DocMuerde/Motor-CC-Control-Lab/datasheets/README.md

# Documentación técnica de componentes / Component technical documentation

[Español](#español) · [English](#english)

## Español

Esta carpeta reúne la documentación técnica y los archivos CAD de los componentes del equipo de prácticas de control de motor CC. Los documentos ya están incluidos en el repositorio y se pueden abrir desde los enlaces siguientes.

### Driver — Toshiba TB6612FNG y placa SparkFun

En [`driver/`](driver/) se incluyen la ficha técnica del circuito integrado y los documentos de diseño de la placa SparkFun:

- [Ficha técnica del TB6612FNG (Toshiba)](driver/TB6612FNG-Datasheet-Toshiba.pdf).
- [Esquema de la placa SparkFun, versión v11c (PDF)](driver/SparkFun_Motor_Driver-TB6612FNG_v11c.pdf).
- [Archivos de diseño Eagle](driver/SparkFun_Motor_Driver-TB6612FNG_v11c/): esquema `.sch` y placa `.brd`.

El diseño de la shield ISA del equipo se encuentra por separado en [`hardware/pcb/`](../hardware/pcb/).

### Encoder — ams AS5047P

En [`encoder/`](encoder/) se incluyen:

- [Ficha técnica del AS5047P (PDF)](encoder/AS5047P-Datasheet.pdf).
- [Imagen del encoder](encoder/AS5047P.png).

### Motor — maxon A-max 22, artículo 110120

En [`motor/`](motor/) se incluyen:

- [Ficha de catálogo del motor (PDF)](motor/Amax22-110120-Datasheet.pdf).
- [Archivos CAD del motor (ZIP)](motor/Amax22-110120-CAD.zip).

### Reductora — maxon GP 22 B, artículo 110356

En [`reductora/`](reductora/) se incluyen:

- [Ficha de catálogo de la reductora (PDF)](reductora/GP22B-110356-Datasheet.pdf).
- [Archivos CAD de la reductora (ZIP)](reductora/GP22B-110356-CAD.zip).

Para utilizar el equipo o instalar su firmware, consulta los [manuales de uso e instalación](../docs/manual/). Esta carpeta contiene material de consulta sobre los componentes.

---

## English

This folder contains technical documentation and CAD files for the components of the DC motor control lab rig. The documents are already included in the repository and can be opened using the links below.

### Driver — Toshiba TB6612FNG and SparkFun board

[`driver/`](driver/) contains the integrated circuit datasheet and the SparkFun board design documents:

- [TB6612FNG datasheet (Toshiba, PDF)](driver/TB6612FNG-Datasheet-Toshiba.pdf).
- [SparkFun board schematic, version v11c (PDF)](driver/SparkFun_Motor_Driver-TB6612FNG_v11c.pdf).
- [Eagle design files](driver/SparkFun_Motor_Driver-TB6612FNG_v11c/): `.sch` schematic and `.brd` board layout.

The rig's ISA shield design is stored separately in [`hardware/pcb/`](../hardware/pcb/).

### Encoder — ams AS5047P

[`encoder/`](encoder/) contains:

- [AS5047P datasheet (PDF)](encoder/AS5047P-Datasheet.pdf).
- [Encoder image](encoder/AS5047P.png).

### Motor — maxon A-max 22, part number 110120

[`motor/`](motor/) contains:

- [Motor catalogue sheet (PDF)](motor/Amax22-110120-Datasheet.pdf).
- [Motor CAD files (ZIP)](motor/Amax22-110120-CAD.zip).

### Gearbox — maxon GP 22 B, part number 110356

[`reductora/`](reductora/) contains:

- [Gearbox catalogue sheet (PDF)](reductora/GP22B-110356-Datasheet.pdf).
- [Gearbox CAD files (ZIP)](reductora/GP22B-110356-CAD.zip).

For instructions on using the rig or installing its firmware, see the [user and installation manuals](../docs/manual/). This folder provides reference material about the components.
