DocMuerde/Motor-CC-Control-Lab/datasheets/motor/README.md

# Motor DC — maxon A-max 22, 5 W (Art. 110120)

## Español

Motor DC de escobillas de la serie A-max de maxon. Utilizado en el equipo de prácticas de control de posición.

### Archivos

| Archivo | Descripción |
|---|---|
| `Amax22-110120-Datasheet.pdf` | Página de catálogo del motor (curvas, parámetros eléctricos y mecánicos) |
| `Amax22-110120-CAD.zip` | Modelo CAD 3D en formato STEP |

### Parámetros principales (Art. 110120)

| Parámetro | Valor |
|---|---|
| Serie | A-max 22 Ø22 mm |
| Potencia nominal | 5 W |
| Tensión nominal | 12 V |
| Escobillas | Metal precioso CLL |
| Terminales | Con terminales (leads) |
| Número de artículo | **110120** |
| Estado | NRND (Not Recommended for New Designs) |

### Referencias

- 🌐 Página del producto: https://www.maxongroup.es/maxon/view/product/110120
- 🌐 Catálogo Maxon: https://www.maxongroup.es

---

<p align="center">🇬🇧 &nbsp;&nbsp; <strong>E N G L I S H</strong> &nbsp;&nbsp; 🇬🇧</p>

---

## English

Brushed DC motor from maxon's A-max 22 series, used in the position-control lab rig.  
Mounted together with the GP 22 B planetary gearbox (Art. 110356) and an inertia disk on the output shaft.

### Files

| File | Description |
|---|---|
| `Amax22-110120-Datasheet.pdf` | Motor catalogue page (curves, electrical and mechanical parameters) |
| `Amax22-110120-CAD.zip` | 3D CAD model in STEP format |

### Main parameters (Art. 110120)

| Parameter | Value |
|---|---|
| Series | A-max 22 Ø22 mm |
| Nominal power | 5 W |
| Nominal voltage | 12 V |
| Brushes | Precious-metal CLL |
| Terminals | With leads |
| Article number | **110120** |
| Status | NRND (Not Recommended for New Designs) |

### References

- 🌐 Product page: https://www.maxongroup.es/maxon/view/product/110120
- 🌐 Maxon catalogue: https://www.maxongroup.es
