DocMuerde/Motor-CC-Control-Lab/datasheets/reductora/README.md

# Reductora — maxon GP 22 B (Art. 110356)

## Español

Reductora planetaria de precisión de la serie GP 22 B de maxon.  
Va acoplada directamente al motor A-max 22 (Art. 110120). El piñón del motor actúa como engranaje de entrada de la primera etapa.

### Archivos

| Archivo | Descripción |
|---|---|
| `GP22B-110356-Datasheet.pdf` | Página de catálogo de la reductora (relación de reducción, par máximo, dimensiones) |
| `GP22B-110356-CAD.zip` | Modelo CAD 3D en formato STEP (cubre también los artículos 110355, 110357–110359) |

### Parámetros principales (Art. 110356)

| Parámetro | Valor |
|---|---|
| Serie | GP 22 B Ø22 mm |
| Par de salida máximo continuo | 0,1 – 0,3 Nm |
| Tipo de cojinete | Sinterizado |
| Montaje | Acoplada de fábrica al motor |
| Número de artículo | **110356** |
| Estado | NRND (Not Recommended for New Designs) |

> ℹ️ Las reductoras GP 22 B solo se venden como parte de una combinación motor + reductora, no de forma independiente.

### Referencias

- 🌐 Página del producto: https://www.maxongroup.es/maxon/view/product/110356
- 🌐 Catálogo Maxon: https://www.maxongroup.es

---

<p align="center">🇬🇧 &nbsp;&nbsp; <strong>E N G L I S H</strong> &nbsp;&nbsp; 🇬🇧</p>

---

## English

Precision planetary gearbox from maxon's GP 22 B series.  
Factory-fitted to the A-max 22 motor (Art. 110120). The motor's pinion serves as the input gear of the first stage.  
Used in the lab rig together with an inertia disk on the output shaft.

### Files

| File | Description |
|---|---|
| `GP22B-110356-Datasheet.pdf` | Gearbox catalogue page (reduction ratio, maximum torque, dimensions) |
| `GP22B-110356-CAD.zip` | 3D CAD model in STEP format (also covers articles 110355, 110357–110359) |

### Main parameters (Art. 110356)

| Parameter | Value |
|---|---|
| Series | GP 22 B Ø22 mm |
| Maximum continuous output torque | 0.1 – 0.3 Nm |
| Bearing type | Sintered |
| Mounting | Factory-fitted to motor |
| Article number | **110356** |
| Status | NRND (Not Recommended for New Designs) |

> ℹ️ GP 22 B gearboxes are only sold as part of a motor + gearbox combination, not separately.

### References

- 🌐 Product page: https://www.maxongroup.es/maxon/view/product/110356
- 🌐 Maxon catalogue: https://www.maxongroup.es
