DocMuerde/Motor-CC-Control-Lab/Claude outputs/lab01_isa.pdf

Control Automático ITT | Práctica 1 Equipo GEPOC

### Control Automático

2

### o Curso Grado en Ingeniería de las Tecnologías de la Telecomunicación

## Práctica de Laboratorio 1

Análisis de un motor de corriente continua

Dpto. de Ingeniería de Sistemas y Automática GEPOC
Universidad de Sevilla | | | ialvarado@us.es

## 1 Objetivos

En esta práctica se va a familiarizar con el equipo de laboratorio basado en Arduino diseñado por el grupo GEPOC, que permite controlar un motor de corriente continua con lazo de control íntegramente en MATLAB/Simulink. Los objetivos concretos son:

Familiarizarse con el hardware y el modelo de Simulink del equipo.
Leer la posición angular y la velocidad proporcionadas por el encoder magnético. Estudiar la calidad de la medida de velocidad y el efecto del ltrado.
Identicar la función de transferencia del motor (ganancia estática K y constante de tiempo τ ) mediante ensayos de escalón.

## 2 Descripción del equipo GEPOC

El banco de prácticas está formado por los siguientes elementos (gura 1):

Motor CC: Maxon A-max 22, con reductora planetaria GP 22B. Encoder: AS5047P, encoder magnético absoluto de 14 bits (2

14 = 16 384 pasos/vuelta), sin contacto y sin rozamiento.
Driver: TB6612FNG, puente en H doble; permite PWM bipolar u ∈ [−255, 255]. Arduino UNO: actúa como nodo de adquisición y actuación. Lee el encoder por SPI, calcula la velocidad y se comunica con el PC mediante protocolo serie binario a 115 200 baud, con período de muestreo Ts = 10 ms (100 Hz).
PC con MATLAB/Simulink: ejecuta el algoritmo de control e intercambia datos con el Arduino a través del puerto USB/serie.

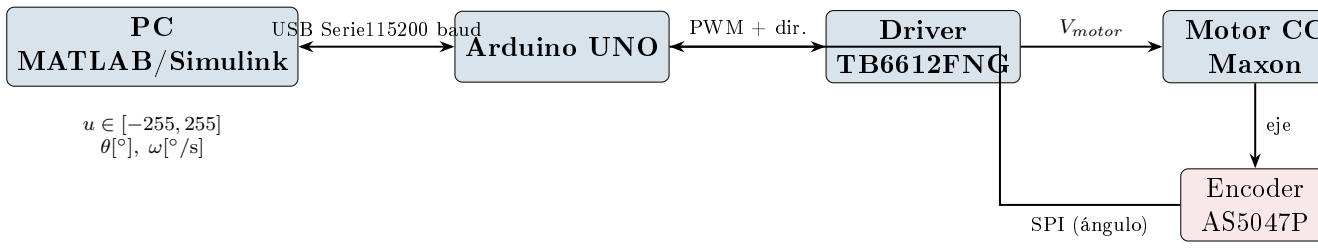
[picture p12: figure]
MATLAB/Simulink; Arduino UNO; Driver; TB6612FNG; Motor CC Maxon; Encoder AS5047P; USB Serie115200 baud; PWM + dir.; Vmotor; eje; SPI (ángulo)

Figure 1: Esquema del equipo de prácticas GEPOC.

### 2.1 Protocolo de comunicación serie

El Arduino y MATLAB intercambian paquetes binarios cada Ts = 10 ms:

Dirección | Trama (bytes) | Contenido
Arduino → MATLAB 'V' | oat θ | oat ω | oat u | '\n' θ [°], ω [°/s], eco de u
MATLAB → Arduino 'A' | int16 u | '\n' | señal de control u ∈ [−255, 255]

La señal de control equivalente en tensión es:

| Veq = u · Vcc
| 255

≈ u ·

12
255
[V] | (1)

## 3 El modelo de Simulink MotorCC_V2

Toda la comunicación serie está encapsulada en el bloque Motor_CC dentro del modelo MotorCC_V2.slx. Los estudiantes no necesitan congurar bloques serie manualmente.

### 3.1 Apertura y conguración del puerto

1. Conecte el cable USB entre el Arduino y el PC.
2. Abra MATLAB y navegue hasta la carpeta del proyecto (software/matlab/).
3. Abra el modelo: open('MotorCC_V2.slx').
4. Haga doble clic sobre el bloque Motor_CC. El diálogo escaneará automáticamente los puertos serie disponibles y los mostrará en el desplegable Puerto serie. Seleccione el puerto del Arduino (p. ej., COM3 en Windows o /dev/tty.usbmodem... en macOS/Linux) y pulse OK.

### 3.2 Entradas y salidas del bloque Motor_CC

El modelo base ya incluye una entrada Constant (valor 50) y un bloque Scope conectados al bloque Motor_CC. Puede modicar el valor de la constante y conectar bloques adicionales según necesite en cada apartado.

Nota

El motor gira en ambas direcciones según el signo de u. Comience con valores pequeños (|u| ≤ 50) para evitar golpes bruscos. La simulación se ejecuta en tiempo real sincronizada con el Arduino.

## 4 Señal de actuación y lectura del sensor

En este apartado va a comprobar el funcionamiento básico del equipo: aplicar una señal de control constante y observar la respuesta del motor.

1. Congure el bloque Constant con el valor u = 50.

2. Ajuste el tiempo de parada de la simulación a 5 s en la barra de herramientas de Simulink.
3. Pulse Run. El scope debe mostrar el ángulo y la velocidad del motor.
4. Repita con u = −50 y con u = 0.

Pregunta #1 Resolución del encoder

a) ¾Cuántos pasos da el encoder AS5047P por revolución?
b) Calcule la resolución en grados y en radianes por paso.
c) El Arduino envía el ángulo acumulado en grados. Si se desea trabajar en radianes, ¾qué factor de conversión hay que aplicar en Simulink?

Pregunta #2 Señal de actuación y velocidad en régimen permanente

Con u = 50:

a) ¾Cuál es la velocidad en régimen permanente en °/s?
b) Convierta ese valor a rad/s.
c) ¾Qué tensión equivalente Veq [V] corresponde a u = 50?
d) ¾Qué ocurre si invierte el signo de u? ¾Y si pone u = 0?

## 5 Medida de velocidad

El Arduino calcula la velocidad como la variación de ángulo entre dos períodos consecutivos:

ω[k] = θ[k] − θ[k − 1]
Ts

[

◦
/s] | (2)

con Ts = 10 ms. Esta diferencia discreta amplica el ruido de cuanticación del encoder.

### 5.1 Observación del ruido de velocidad

1. Aplique u = 50 y observe en el Scope la señal de velocidad ω en régimen permanente. Haga zoom en unos pocos ciclos para apreciar la variación de muestra a muestra.
2. Estime visualmente la amplitud pico a pico del ruido de velocidad.

### 5.2 Filtrado paso bajo de la velocidad

Para atenuar el ruido, se puede añadir un ltro paso bajo de primer orden en Simulink:

F(s) = ωc
s + ωc

(3)

Añada un bloque Transfer Fcn entre la salida ω del bloque Motor_CC y el Scope, con numerador [ωc] y denominador [1, ωc]. Pruebe con ωc = 50 rad/s (frecuencia de corte ≈ 8 Hz).

Nota

Recuerde establecer el tiempo de muestreo del bloque Transfer Fcn en −1 (hereda del solver). El solver de Simulink debe ser de paso jo con Tstep = 0.01 s.

Pregunta #3 Calidad de la medida de velocidad

a) ¾Cuál es la resolución mínima de velocidad que puede detectar el encoder para Ts = 10 ms? (Recuerde: 16 384 pasos/vuelta.)
b) Compare cualitativamente la señal de velocidad sin ltrar y con el ltro F(s) = 50/(s + 50): ¾qué mejora se observa en el ruido? ¾Y qué retardo introduce el ltro?
c) ¾Qué criterio usaría para elegir ωc? Razone en términos de compromiso entre atenuación de ruido y retardo.

## 6 Identicación de la función de transferencia

Se va a identicar el modelo de primer orden del motor usando ensayos de escalón:

G(s) = Ω(s)
Veq(s)

=

K
τs + 1

(4)

donde Ω(s) es la velocidad en rad/s, Veq(s) es la tensión equivalente en voltios, K [rad s⁻¹ V⁻¹ ]
es la ganancia estática y τ [s] la constante de tiempo.

### 6.1 Procedimiento

1. Modique el modelo para que el bloque Constant proporcione la señal de control.
| Para el ensayo de escalón, utilice u = 50 (equivalente a Veq ≈ 2.35 V).
2. Añada una conversión a rad/s multiplicando la salida ω por π/180 (bloque Gain).
3. Congure la simulación para al menos 2 s de duración.
4. Ejecute la simulación partiendo del motor en reposo.
5. Exporte los datos del Scope a MATLAB pulsando el botón Log/unlog signals o
| usando simout con un bloque To Workspace.
6.2 | Determinación gráca de K y τ

A partir de la respuesta al escalón (gura 2):

Ganancia estática:
K =

ωss

Veq

(5)

donde ωss es la velocidad en régimen permanente.
Constante de tiempo: τ es el tiempo que tarda la velocidad en alcanzar el 63.2% de ωss desde el inicio del escalón.

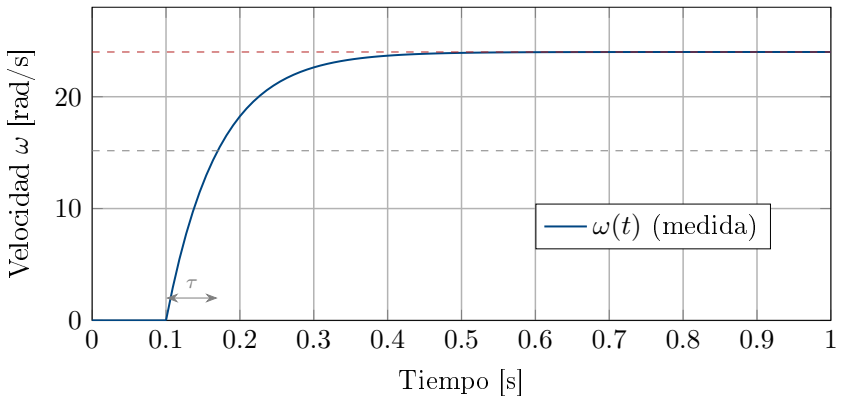
[picture p13: figure]
Tiempo [s]; Velocidad; ω [rad/s]; ω(t) (medida)

Figure 2: Respuesta al escalón de velocidad. Se identican grácamente la velocidad en régimen permanente ωss y la constante de tiempo τ .

Pregunta #4 Función de transferencia (con y sin reductora)

a) Aplique el escalón u = 50 (Veq ≈ 2.35 V) y determine ωss en rad/s.
b) Calcule la ganancia estática K usando la ecuación (5).
c) Determine τ grácamente a partir de la curva de respuesta.
d) Escriba la función de transferencia G(s) = K/(τs + 1) con los valores obtenidos.

Pregunta #5 Validación del modelo

a) Repita el ensayo con u = −50. ¾Es el sistema simétrico? ¾Obtiene los mismos valores de K y τ?
b) Repita con u = 100. ¾Se mantiene la linealidad? Razone la respuesta.
c) Usando la función de transferencia identicada y la herramienta step de MATLAB (o el bloque Transfer Fcn en Simulink), superponga la respuesta del modelo sobre la medida experimental. ¾El ajuste es satisfactorio?

Pregunta #6 Efecto de la reductora

El motor lleva acoplada una reductora planetaria GP 22B. ¾Cómo afecta la reductora a la constante de tiempo τ y a la ganancia estática K en comparación con un motor sin reductora? Razone cualitativamente.

## Hoja de respuestas

### Hoja de respuestas Práctica 1

Nombre:

Dato solicitado | Respuesta
#1 Resolución del encoder

#2 Velocidad en régimen permanente (u = 50)

#3 Calidad de la medida de velocidad

#4 Función de transferencia G(s)

#5 Validación del modelo

#6 Efecto de la reductora

## A El encoder magnético AS5047P

A diferencia de los encoders ópticos incrementales, el AS5047P es un encoder magnético absoluto de 14 bits. Sus principales características son:

Resolución: 2

14 = 16 384 posiciones por vuelta ⇒ resolución de 360/16 384 ≈ 0.022 /paso.
Lectura absoluta: No necesita referencia inicial (homing) ni contador de pulsos; devuelve el ángulo directamente en cada lectura SPI.
Sin contacto: El sensor lee el campo magnético de un imán solidario al eje; no hay desgaste mecánico ni rozamiento.
Interfaz: SPI a hasta 10 MHz (el rmware usa 400 kHz para mayor robustez).

El rmware de Arduino acumula el ángulo entre vueltas para proporcionar una posición angular absoluta ilimitada:

θabs[k] = θraw[k] + 360 · nvueltas | (6)

donde θraw ∈ [−180, 180) y nvueltas se actualiza cada vez que se detecta un cruce por ±180. La velocidad se calcula directamente en el rmware como:

ω[k] = θabs[k] − θabs[k − 1] Ts

[

◦
/s], | Ts = 10 ms | (7)
