DocMuerde/Motor-CC-Control-Lab/Claude outputs/lab02_isa.pdf

Control Automático ITT | Práctica 2 Equipo GEPOC

### Control Automático

2

### o Curso Grado en Ingeniería de las Tecnologías de la Telecomunicación

## Práctica de Laboratorio 2

Control PID de un motor de corriente continua

Dpto. de Ingeniería de Sistemas y Automática GEPOC
Universidad de Sevilla | | | ialvarado@us.es
1 | Objetivos

Esta práctica continúa el trabajo iniciado en la práctica 1 con el equipo GEPOC. Los objetivos son:

Repetir la identicación del sistema y analizar la zona muerta del motor.
Diseñar e implementar un controlador de velocidad: primero proporcional (P) y después proporcional-integral (PI).
Diseñar e implementar un controlador de posición: proporcional-derivativo (PD) y proporcional-integral-derivativo (PID).
Comprender la inuencia de cada parámetro del controlador PID y el efecto de la zona muerta en el error en régimen permanente.

Nota

Para toda esta práctica puede suponer que el punto de funcionamiento en tensión es nulo (V0 = 0), por lo que no es necesario el paso a variables incrementales.

2 | Análisis del sistema
2.1 | Identicación (revisión)
1. Abra el modelo MotorCC_V2.slx y congure el puerto serie haciendo doble clic en el bloque Motor_CC.
2. Partiendo del modelo de Simulink de la práctica 1 (bloque Motor_CC con la salida de velocidad en rad/s, opcionalmente ltrada), aplique un escalón desde u = 0 hasta u = 42 (Veq ≈ 2.0 V) y verique que el modelo funciona correctamente.

Pregunta #1 Función de transferencia

Repita la identicación del apartado 3 de la práctica 1 con el escalón u = 42 (Veq ≈ 2.0 V). Anote la función de transferencia G(s) = K/(τs + 1) con los valores de K y τ obtenidos. Esta función de transferencia se utilizará en los apartados siguientes.

### 2.2 Zona muerta

La zona muerta es un fenómeno no lineal: por debajo de cierta tensión de entrada, el motor no se mueve porque la fricción estática del conjunto motor+reductora supera el par motor. Los límites de zona muerta son distintos para cada sentido de giro.

1. Congure el bloque Constant con un valor inicial u = 5. Ejecute la simulación y compruebe si el motor se mueve observando la señal de velocidad ω en el Scope.
2. Vaya aumentando u de en 1 en 1 hasta detectar el valor mínimo para el cual el motor gira. Anótelo como u

+
ZM.
3. Repita con valores negativos para encontrar u

−
ZM.

Pregunta #2 Zona muerta

a) ¾Cuáles son los límites de la zona muerta u

+
ZM y u

−
ZM?
b) Conviértalos a tensión equivalente: V

±
ZM = u

±
ZM · 12/255.
c) ¾Es la zona muerta simétrica para ambos sentidos? ¾Por qué podría no serlo?
d) ¾Qué implicación tiene la zona muerta para los controladores que diseñará a continuación?

## 3 Control de la velocidad del motor

La gura 1 muestra el esquema de control de velocidad en bucle cerrado. La referencia ωr se compara con la velocidad medida ω; el error e = ωr −ω es procesado por el controlador C(s) para generar la señal de control u.

+ | C(s) | G(s) = | K τs + 1
ωr
e | u | ω

−−

Figure 1: Esquema de control de velocidad en bucle cerrado.

### 3.1 Controlador proporcional (P)

1. Modique el modelo de Simulink para implementar un controlador P: añada un
| bloque Sum que reste la velocidad medida a la referencia, conecte la salida al bloque Motor_CC a través de un Gain Kp.
2. Como referencia, use un Pulse Generator con amplitud ±20 rad/s y frecuencia
| 0.4 Hz (período 2.5 s).
3. Pruebe distintos valores de Kp y analice el comportamiento del sistema (error en
| régimen permanente, sobreimpulso, oscilaciones).

4. Introduzca perturbaciones presionando suavemente el eje del motor con un dedo y observe la reacción del controlador.

Pregunta #3 Controlador proporcional

a) ¾Existe error en régimen permanente con el controlador P? ¾A qué se debe? (Pista: recuerde el tipo del sistema en bucle cerrado.)
b) ¾Cómo afecta aumentar Kp al error y a la estabilidad?
c) ¾Responde el sistema adecuadamente a las perturbaciones? ¾Qué valor de Kp parece un compromiso razonable?

### 3.2 Diseño analítico del controlador PI

El objetivo de diseño es conseguir que el sistema en bucle cerrado se comporte como un sistema de primer orden con constante de tiempo τcl = 0.1 s y ganancia estática unitaria. El controlador PI tiene la forma:

C(s) = Kp

Tis + 1
Tis

(1)

La función de transferencia en bucle cerrado con el controlador (1) y la planta G(s) = K/(τs + 1) es:
T(s) = C(s) G(s)
1 + C(s) G(s)

(2)

Procedimiento de diseño (cancelación polo-cero):

1. Cancelación: Elija Ti = τ para cancelar el polo de la planta. Así C(s) G(s) = KpK/(Tis).
2. Especicación: La función de bucle cerrado resultante es:

T(s) = 1

Ti
KpK

s + 1

=

1
τcl s + 1

⇒ τcl =

Ti
KpK

(3)

3. Cálculo: De (3) se obtiene Kp = Ti/(K τcl) = τ/(K · 0.1 s).
1. Calcule Kp y Ti con la función de transferencia identicada en #1.
2. Implemente el controlador PI en Simulink usando un bloque Transfer Fcn con numerador [KpTi

, Kp] y denominador [Ti

, 0], o bien con un bloque PID Controller con Kp, Ki = Kp/Ti
, Kd = 0.
3. Añada una saturación a la salida del controlador para limitar u ∈ [−255, 255].
4. Ejecute la simulación con la referencia en escalones ±20 rad/s a 0.4 Hz.

Pregunta #4 Control PI de velocidad

a) Anote los valores de Kp y Ti calculados.
b) ¾Se elimina el error en régimen permanente? ¾Por qué el PI consigue esto?
c) Si es necesario, ajuste Kp manualmente para mejorar la respuesta (rapidez, sobreimpulso). Anote el valor nal utilizado.
d) Introduzca perturbaciones con el dedo. ¾Cómo responde el PI frente al controlador P? Razone en base a la acción integral.

## 4 Control de la posición del motor

Ahora la variable a controlar es la posición angular θ en radianes. El esquema de control es idéntico al de la gura 1 pero con θr como referencia y θ como salida (gura 2).

+ | C(s) | Gθ(s) = | K τs² + s
θr
e | u | θ

−−

Figure 2: Esquema de control de posición en bucle cerrado. La planta Gθ(s) incluye el integrador implícito entre velocidad y posición.

La función de transferencia de la posición respecto a la tensión es:

Gθ(s) = Θ(s)
Veq(s)

=

G(s)
s

=

K
s(τs + 1) | (4)

pues la posición es la integral de la velocidad.

### 4.1 Diseño analítico del controlador PD

El objetivo de diseño para posición es un sistema en bucle cerrado de primer orden con τcl = 0.02 s y ganancia estática unitaria.
El controlador PD (con la derivada ltrada para que sea implementable):
C(s) = Kp (1 + Td s) | (5)

Procedimiento (cancelación polo-cero):

1. Elija Td = τ para cancelar el polo de la planta. La función de bucle resulta C(s) Gθ(s) = KpK/s.
2. La función de bucle cerrado es:

T(s) = KpK/s
1 + KpK/s =

1

1
KpK

s + 1

=

1
τcl s + 1

⇒ Kp =

1
K τcl

(6)

3. Calcule Kp con τcl = 0.02 s.

Nota

La acción derivativa pura es no implementable. Use el bloque PID Controller de Simulink con Kd y un ltro de derivada con coeciente N (el PD queda: C(s) = Kp + KpTds N/(s + N)). Comience con N = 100.

1. Modique el modelo de Simulink para controlar la posición:

Conecte la salida de posición θ [°] del bloque Motor_CC, conviértala a rad (multiplicar por π/180) y réaliméntela.
Como referencia, use un Pulse Generator con amplitud ±0.5 rad y frecuencia 0.1 Hz (período 10 s).
2. Implemente el controlador PD con Kp calculado y Td = τ .
3. Ejecute la simulación y analice el resultado.

Pregunta #5 Control PD de posición

a) Anote los valores de Kp y Td calculados.
b) ¾Se obtiene el comportamiento de primer orden esperado con τcl = 0.02 s?
c) ¾Existe error en régimen permanente? ¾A qué se debe? (Pista: piense en el efecto de la zona muerta.)
d) Si es necesario, ajuste Kp manualmente para mejorar la respuesta. ¾Qué compromiso aparece al aumentar Kp?

### 4.2 Control PID: reducción del error en régimen permanente

El error en régimen permanente con control PD se debe principalmente a la zona muerta:
el controlador no puede generar la pequeña acción de control necesaria para compensar la fricción estática. La acción integral del PID puede reducir (aunque no eliminar completamente) este error.
1. Parta del controlador PD anterior y añada acción integral:
| C(s) = Kp
| 1 +
| 1 Tis + Tds
(7)
| Comience con un valor de Ti grande (p. ej., Ti = 1 s) y vaya reduciéndolo mientras el sistema permanezca estable.
2. Observe el efecto de la acción integral sobre el error en régimen permanente y sobre
| el sobreimpulso.
3. Ajuste los tres parámetros Kp, Ti y Td por prueba y error para obtener la mejor
| respuesta posible (mínimo error y mínimo sobreimpulso).

Pregunta #6 Control PID de posición

a) Anote los parámetros nales del PID (Kp, Ti

, Td).

b) ¾Se reduce el error en régimen permanente con la acción integral? ¾Lo elimina completamente? ¾Por qué?
c) ¾Qué problema aparece si Ti es demasiado pequeño?
d) Razone si es posible diseñar un PID analíticamente cuando el sistema presenta zona muerta. ¾Qué herramientas de diseño serían necesarias?
e) Compare las respuestas PD y PID en la misma gráca. ¾Cuál preferiría para esta aplicación? Justique la respuesta.

## Hoja de respuestas

### Hoja de respuestas Práctica 2

Nombre:
Dato solicitado | Respuesta
#1 Función de transferencia G(s)

#2 Límites de zona muerta (u + ZM, u − ZM)

#3 Comportamiento controlador P (Kp elegido)

#4 Control PI de velocidad (Kp, Ti)

#5 Control PD de posición (Kp, Td)

#6 Control PID de posición (Kp, Ti , Td)

## A Implementación del controlador PID en Simulink

Simulink dispone del bloque PID Controller (en la librería Simulink/Continuous) que implementa directamente el PID en la forma:

| u(t) = Kp e(t) + Kp Ti

Z t
| 0 e(σ) dσ + Kp Td N e(t) 1 + N R t
| 0 e(σ) dσ · . . .

(8)

o de forma equivalente en frecuencia:

| C(s) = Kp + Kp Ti s + Kp Td N s s + N
(9)

donde N es el coeciente de ltrado de la derivada. Un valor típico de N ∈ [20, 200] asegura que la derivada sea implementable y no amplique excesivamente el ruido de alta frecuencia.
Congure el bloque PID en MATLAB/Simulink de la siguiente manera:
1. Arrastre un bloque PID Controller al diagrama.
2. Haga doble clic y seleccione el tipo (P, PI, PD o PID).
3. Introduzca los parámetros Kp (proporcional), Ti (integral), Td (derivativo) y N (ltro de derivada).
4. Añada siempre un bloque Saturation a la salida del controlador limitando u ∈ [−255, 255] para no saturar el driver del motor.

### Anti-windup

Cuando la señal de control satura, el integrador puede seguir acumulando error (windup), provocando sobretensiones al salir de la saturación. Habilite el anti-windup en el bloque PID seleccionando el método Back-calculation con constante de rastreo Kb = 1/Ti
