DocMuerde/Motor-CC-Control-Lab/labs/lab01/figuras/README.txt

Figuras pendientes para lab01_slides.tex
=========================================

Sección 2 — Lab virtual con Simulink
--------------------------------------
[ ] simulink_modelo_completo.png   — Vista del modelo MotorCC_V3.slx completo
[ ] simulink_dashboard_knob.png    — Knob + Edit configurados para u
[ ] simulink_dashboard_scope.png   — Dashboard Scope con dos señales (u, omega)
[ ] simulink_pacing.png            — Configuración Simulation Pacing (1x real-time)
[ ] simulink_data_inspector.png    — Data Inspector con señales logged

Sección 3 — Puesta en marcha
------------------------------
[ ] verificacion_u50.png           — Scope con u=50 y omega estabilizada
[ ] verificacion_u-50.png          — Scope con u=-50 (giro inverso)

Sección 4 — Experimentos
--------------------------
[ ] exp1_saturacion.png            — Scope exp. saturación (u=300 vs u=255)
[ ] exp2_estatica_grafica.png      — plot(u_vec, w_vec) característica estática
[ ] exp3_escalon.png               — Scope respuesta escalón con tau marcado
[ ] exp3_validacion.png            — Comparación step(G) vs datos reales

Notas
------
- Resolución mínima recomendada: 1200×800 px
- Exportar desde MATLAB con: print('-dpng','-r150','nombre.png')
- Copiar aquí y referenciar en .tex como: figuras/nombre.png
