DocMuerde/Motor-CC-Control-Lab/datasheets/encoder/AS5047P.png

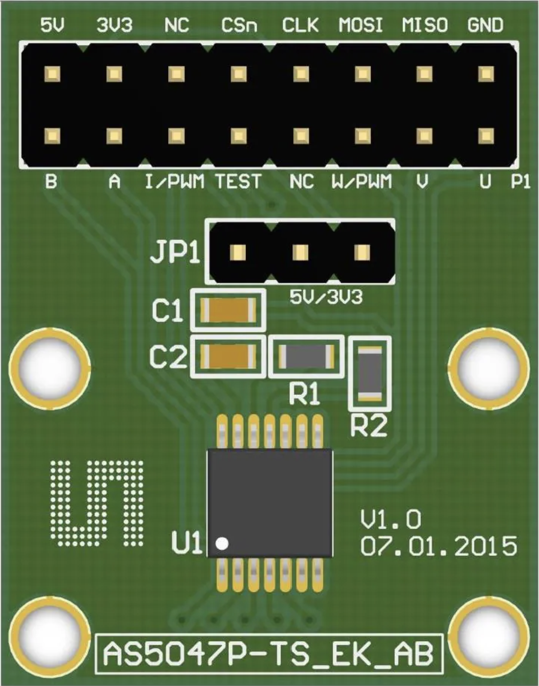
datasheets/encoder/AS5047P.png
