DocMuerde/Motor-CC-Control-Lab/docs/images/matlab/07_mask_editor_parameters_group.png

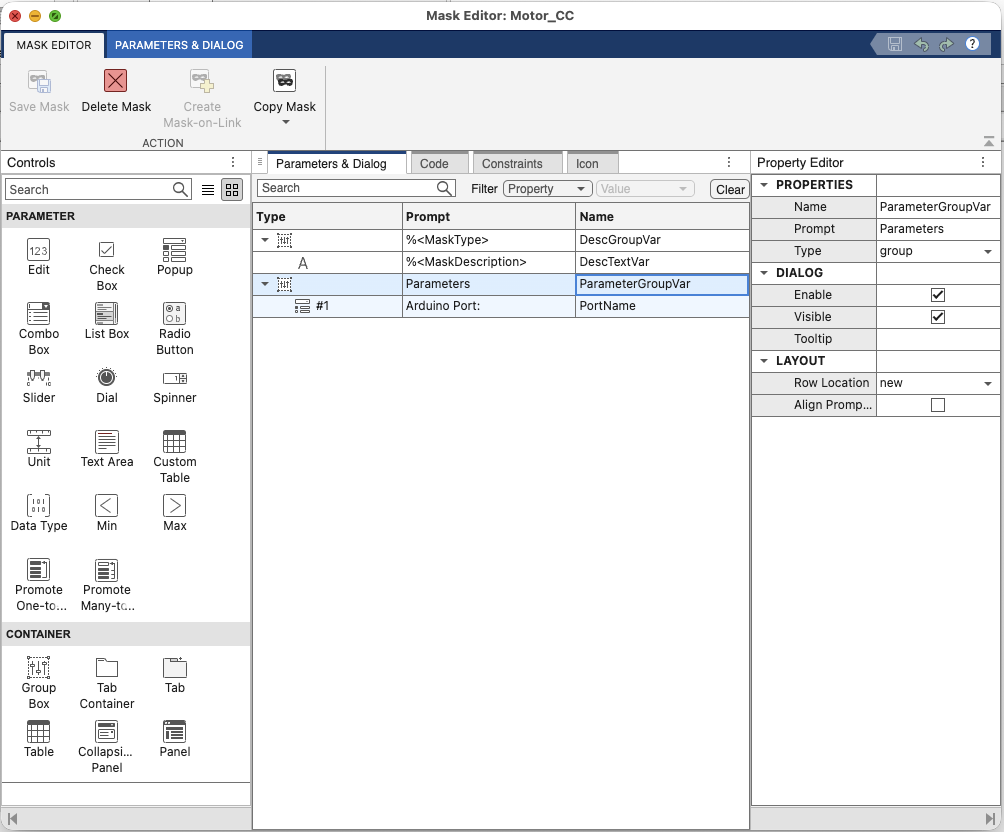
docs/images/matlab/07_mask_editor_parameters_group.png
