DocMuerde/Motor-CC-Control-Lab/docs/images/matlab/08_mask_editor_portname_props.png

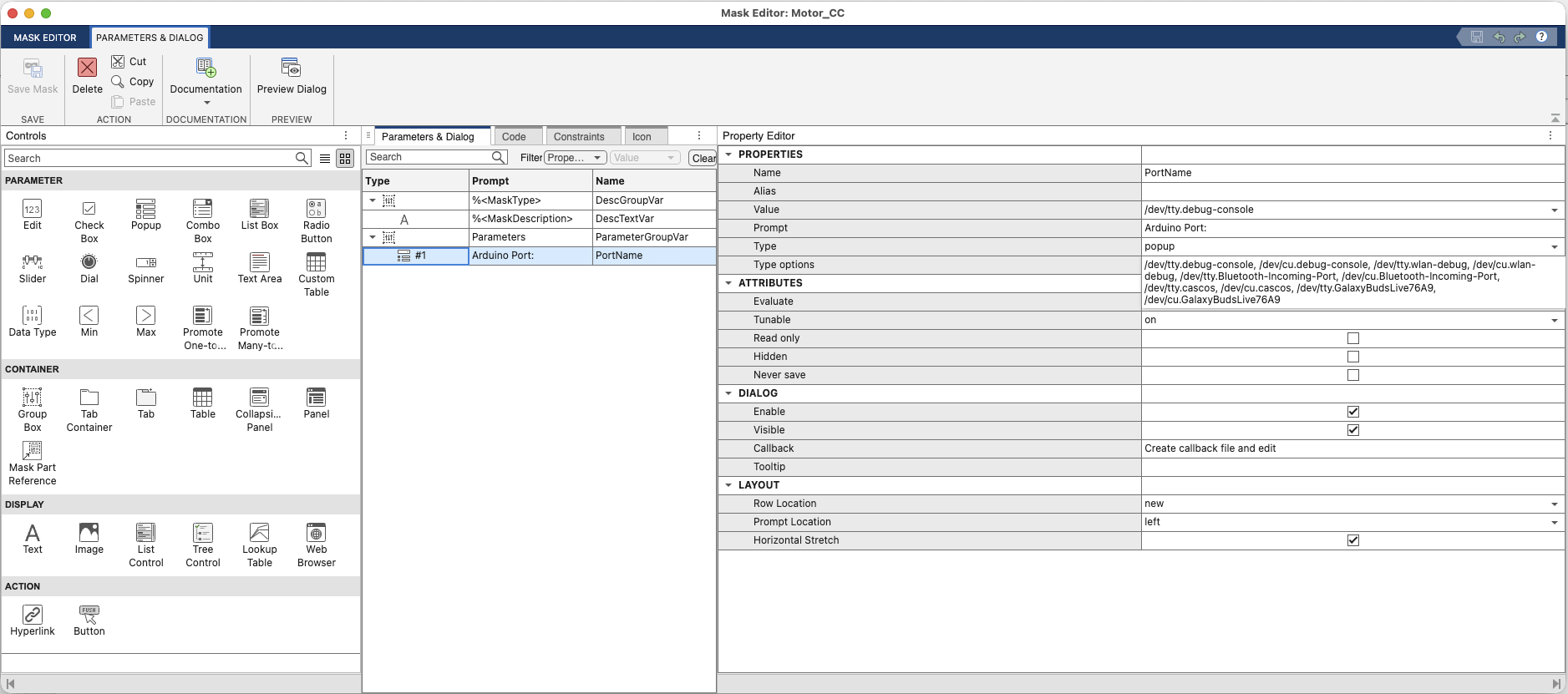
docs/images/matlab/08_mask_editor_portname_props.png
