DocMuerde/Motor-CC-Control-Lab/docs/images/matlab/09_mask_editor_code_tab.png

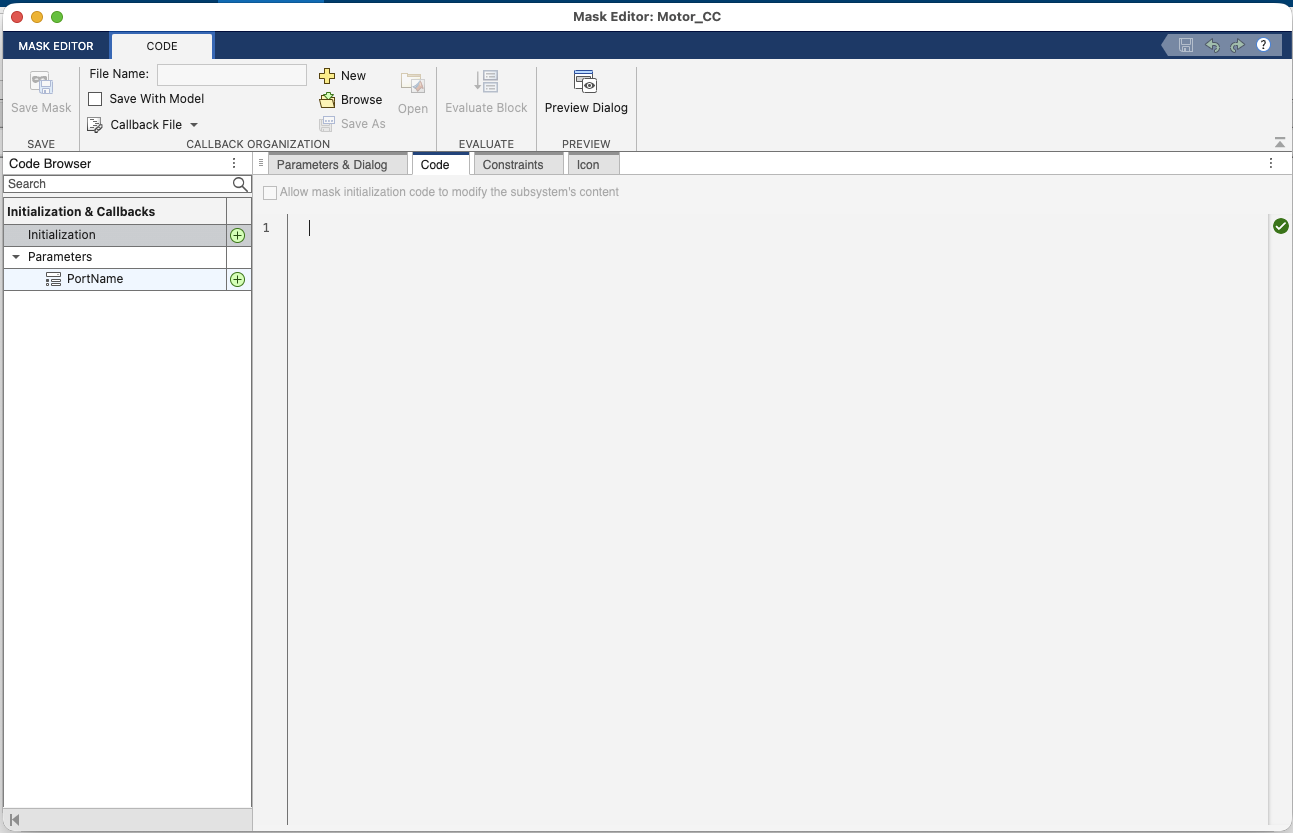
docs/images/matlab/09_mask_editor_code_tab.png
