DocMuerde/Motor-CC-Control-Lab/docs/images/matlab/10_block_properties_openfcn.png

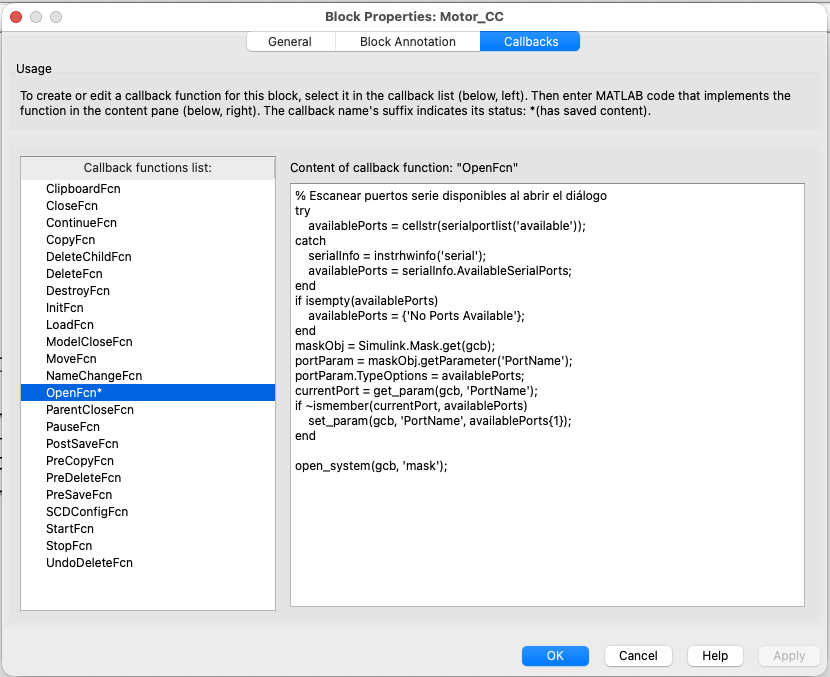
docs/images/matlab/10_block_properties_openfcn.png
