DocMuerde/Motor-CC-Control-Lab/hardware/pcb/BOM_Control_Motor_CC_2026-11-06.csv

ID | Name | Designator | Footprint | Quantity | Manufacturer Part | Manufacturer | Supplier | Supplier Part | Price
1 | 0.1UF | C1 | CAP-TH_L10.0-W4.5-P7.50-D0.6 | 1 | 250V 0.1UF 5% CBBCapacitor | ReliaPro | LCSC | C46804
2 | KH-2.54PH180-2X8P-L8.9 | CN1 | CONN-TH_16P-P2.54_KINGHELM_KH-2.54PH180-2X8P-L8.9 | 1 | KH-2.54PH180-2X8P-L8.9 | kinghelm(金航标) | LCSC | C5157631 | 0.174
3 | ARDUINO_R3_SHIELD | J1 | UNO_R3_SHIELD | 1 | ?
4 | TB6612FNG COPYUPDATED | TB66121 | TB6612FNG-BY-METHEE1 | 1
5 | 10uF | U2 | CAP-TH_BD10.0-P5.00-D0.6-FD | 1 | 420BXC10MEFC10X20 | rubycon(红宝石) | LCSC | C5115032 | 0.387
6 | Motor 2 | U4 | TERMINAL_BLOCK_0.5/2-2.54MM | 1 | MTP0.5/4-2.54 | Phoenix Contact | Element14 | 3041414
7 | Motor_1 | U18 | TERMINAL_BLOCK_0.5/2-2.54MM | 1 | MTP0.5/4-2.54 | Phoenix Contact | Element14 | 3041414
