DocMuerde/Motor-CC-Control-Lab/hardware/3d-printing/step/Eq_practicas v83 v7.step

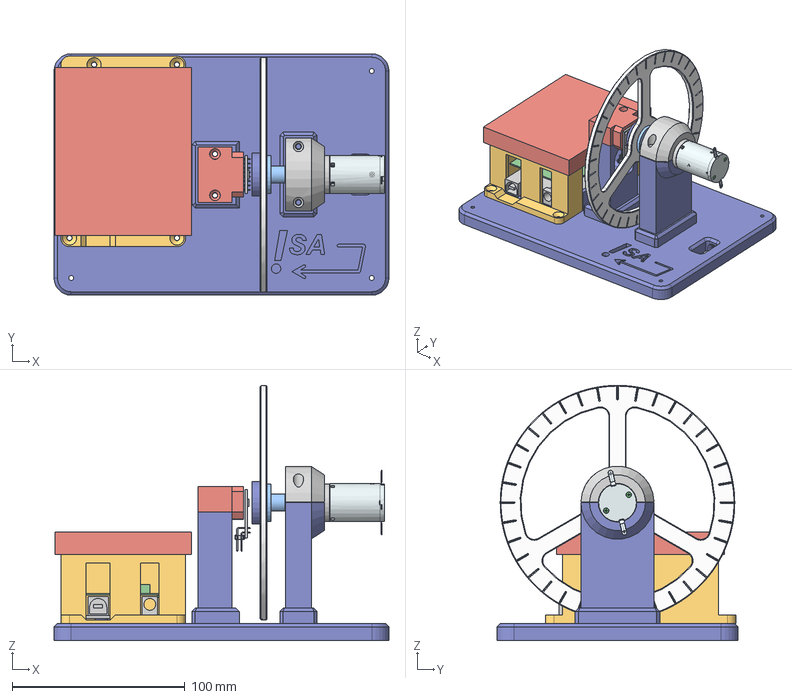
[picture p26: CAD file, 2026-11-06]
hardware/3d-printing/step/Eq_practicas v83 v7.step
194.2 x 140.0 x 148.0 mm
110117_Amax22_EB_5W_SL_1WE
110357_GP22B_0_2NM_3ST_SL
AS5047P-pcb
2-8p
Arduino_Uno
Adaptador
Arragarre_motor
PCB_Control_Motor_CC
SSensor_integrado
Base_Compuesta
Disco_met
