DocMuerde/Motor-CC-Control-Lab/hardware/3d-printing/stl/Caja.stl

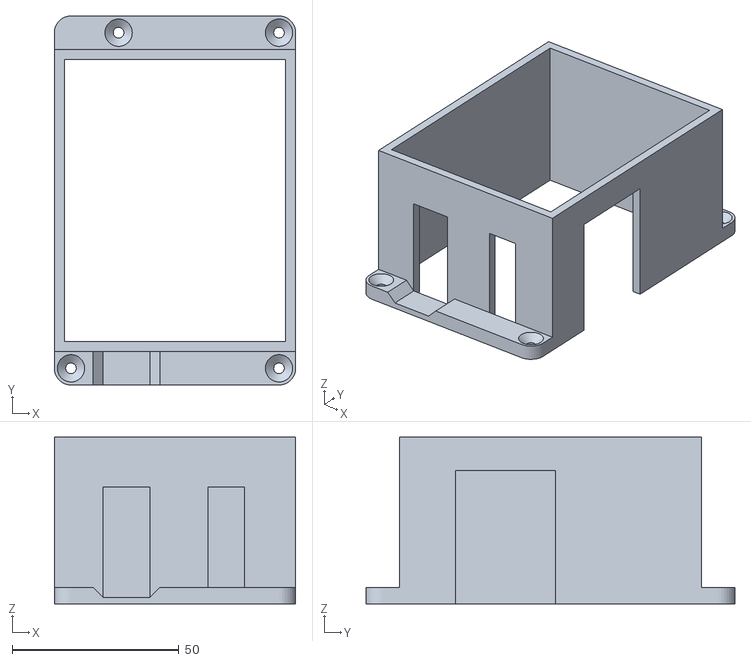
[picture p27: CAD file, 2026-11-06]
hardware/3d-printing/stl/Caja.stl
72.3 x 110.5 x 50.0
