DocMuerde/Motor-CC-Control-Lab/hardware/3d-printing/stl/SMotor.stl

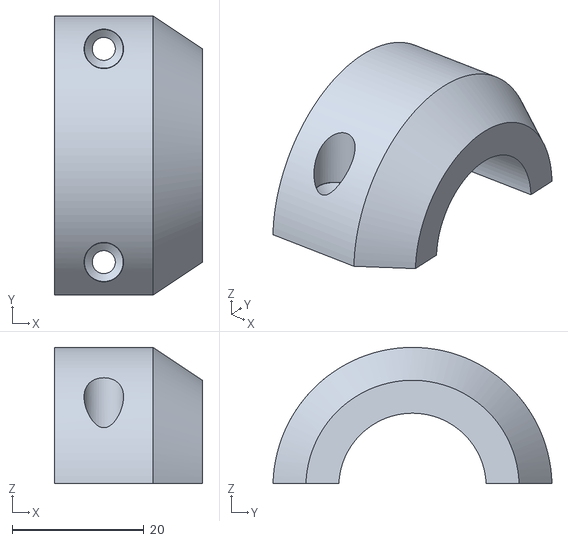
[picture p28: CAD file, 2026-11-06]
hardware/3d-printing/stl/SMotor.stl
22.5 x 42.4 x 20.7
