DocMuerde/Motor-CC-Control-Lab/hardware/3d-printing/stl/SSensor_integrado.stl

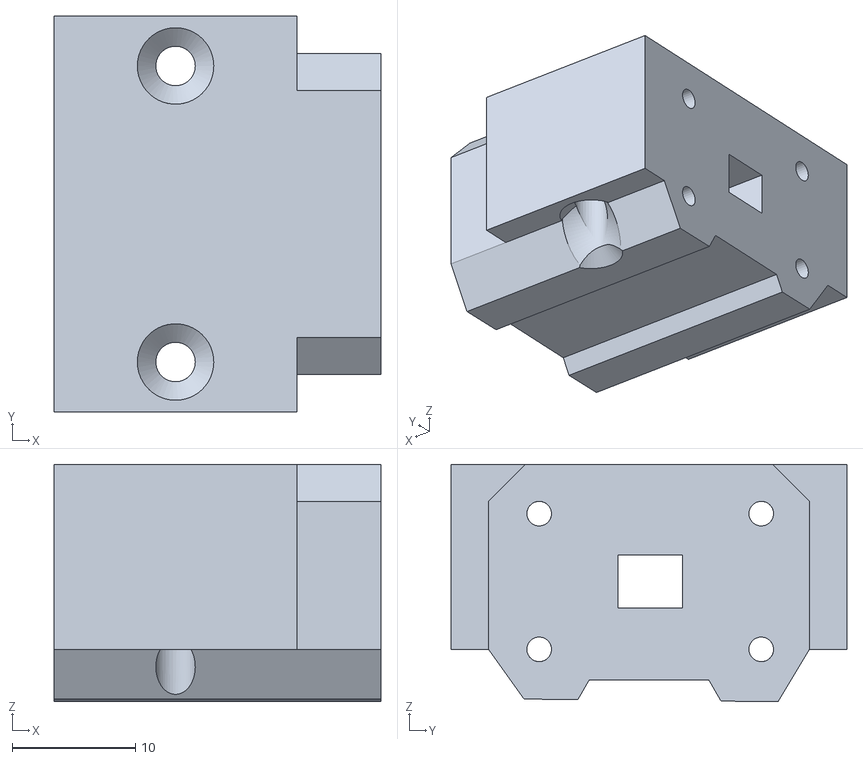
[picture p29: CAD file, 2026-11-06]
hardware/3d-printing/stl/SSensor_integrado.stl
26.5 x 32.1 x 19.2
