DocMuerde/Motor-CC-Control-Lab/hardware/3d-printing/stl/Disco_inercia.stl

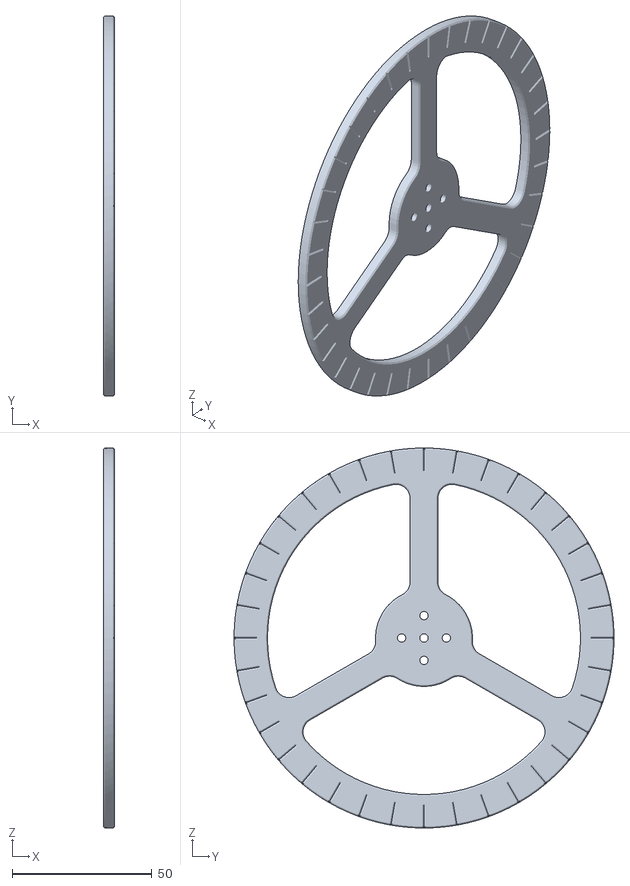
[picture p30: CAD file, 2026-11-06]
hardware/3d-printing/stl/Disco_inercia.stl
4.00 x 136.0 x 136.0
