DocMuerde/Motor-CC-Control-Lab/hardware/3d-printing/stl/Tapa.stl

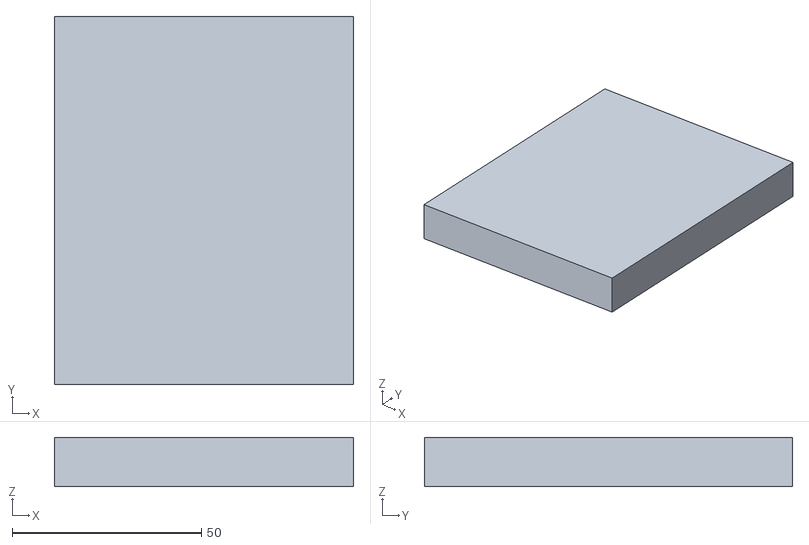
[picture p31: CAD file, 2026-11-06]
hardware/3d-printing/stl/Tapa.stl
79.1 x 97.3 x 13.0
