DocMuerde/Motor-CC-Control-Lab/hardware/3d-printing/stl/Soporte_disco.stl

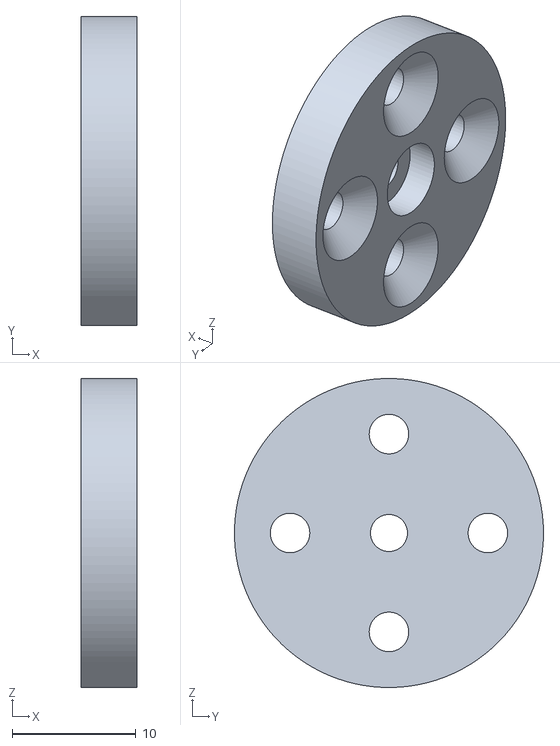
[picture p32: CAD file, 2026-11-06]
hardware/3d-printing/stl/Soporte_disco.stl
4.50 x 25.0 x 25.0
