DocMuerde/Motor-CC-Control-Lab/hardware/3d-printing/stl/Base.stl

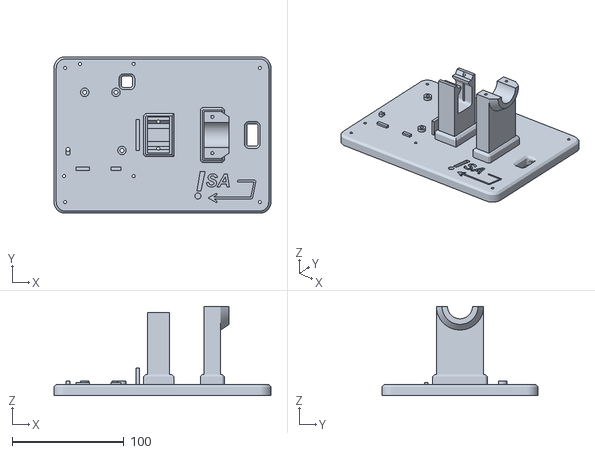
[picture p33: CAD file, 2026-11-06]
hardware/3d-printing/stl/Base.stl
194.2 x 140.0 x 80.0
