DocMuerde/Motor-CC-Control-Lab/hardware/3d-printing/stl/Adaptador.stl

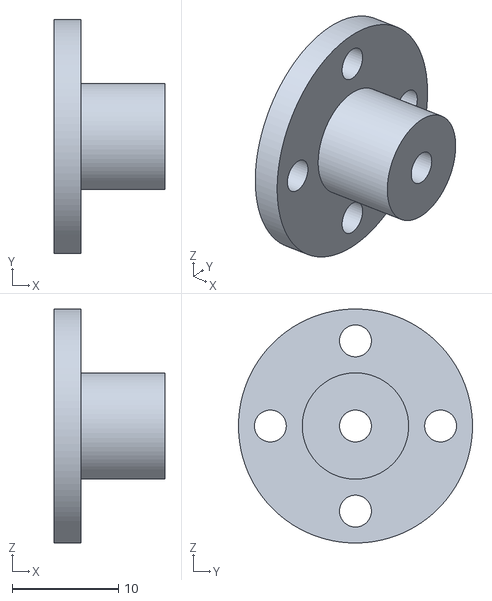
[picture p34: CAD file, 2026-11-06]
hardware/3d-printing/stl/Adaptador.stl
10.4 x 22.0 x 22.0
