DocMuerde/Motor-CC-Control-Lab/docs/manual/README.md

# Manuales / Manuals

## Uso del equipo / Using the rig

Con el firmware ya instalado. MATLAB con Simulink y **Instrument Control Toolbox como única toolbox adicional**. Guía rápida de una página, con anexo de instalación de la toolbox.

With firmware already installed. MATLAB with Simulink and **Instrument Control Toolbox as the only additional toolbox**. One-page quick start guide, with a toolbox installation appendix.

- Español: [Guía rápida de uso](manual_usuario_isa.pdf) · [LaTeX](manual_usuario_isa.tex)
- English: [Quick start guide](user_manual_isa.pdf) · [LaTeX](user_manual_isa.tex)

## Instalación del firmware / Firmware installation

Solo para un Arduino nuevo o para actualizar el firmware. Incluye las bibliotecas de Arduino y los pasos de carga.

Only for a new Arduino or a firmware update. Includes Arduino libraries and upload steps.

- Español: [Instalación del firmware](instalacion_firmware_isa.pdf) · [LaTeX](instalacion_firmware_isa.tex)
- English: [Firmware installation](firmware_installation_isa.pdf) · [LaTeX](firmware_installation_isa.tex)
