DocMuerde/Motor-CC-Control-Lab/docs/manual/manual_usuario_isa.tex

\documentclass[11pt,a4paper]{article}
\usepackage[utf8]{inputenc}
\usepackage[T1]{fontenc}
\usepackage[spanish]{babel}
\usepackage{lmodern}
\usepackage[left=2cm,right=2cm,top=1.8cm,bottom=1.8cm]{geometry}
\usepackage{graphicx}
\usepackage{xcolor}
\usepackage{tikz}
\usetikzlibrary{arrows.meta,positioning}
\usepackage{enumitem}
\usepackage[hidelinks]{hyperref}
\definecolor{isa}{RGB}{0,70,130}
\setlength{\parindent}{0pt}
\setlength{\parskip}{3pt}
\setlist[enumerate]{leftmargin=*,itemsep=3pt,topsep=3pt}
\setlist[itemize]{leftmargin=*,itemsep=2pt,topsep=3pt}
\begin{document}
\sloppy
\noindent\begin{minipage}[c]{0.76\linewidth}
{\LARGE\bfseries\color{isa} Guía rápida de uso}\par
{\large Equipo de prácticas de control de motor CC}\par
{\small ISA · Universidad de Sevilla\\\href{mailto:ialvarado@us.es}{ialvarado@us.es}}
\end{minipage}\hfill
\begin{minipage}[c]{0.22\linewidth}
\centering

\end{minipage}\par
\smallskip\hrule\medskip

\textbf{Punto de partida:} el equipo está montado y el firmware ya está instalado en Arduino.

\textbf{Software necesario: MATLAB con Simulink. La única toolbox adicional necesaria para utilizar el equipo es Instrument Control Toolbox.} No se necesita Arduino IDE, el paquete de soporte de Arduino ni otras toolboxes para comunicar con el equipo.

\textbf{Comprueba la instalación:} en la ventana de comandos de MATLAB (\emph{Command Window}), escribe \textbf{\texttt{ver}} y pulsa Intro. Debe aparecer \textbf{Instrument Control Toolbox} en la lista de productos instalados. Si no aparece, sigue el anexo de instalación al final de esta guía.

\begin{center}\vspace{-3pt}
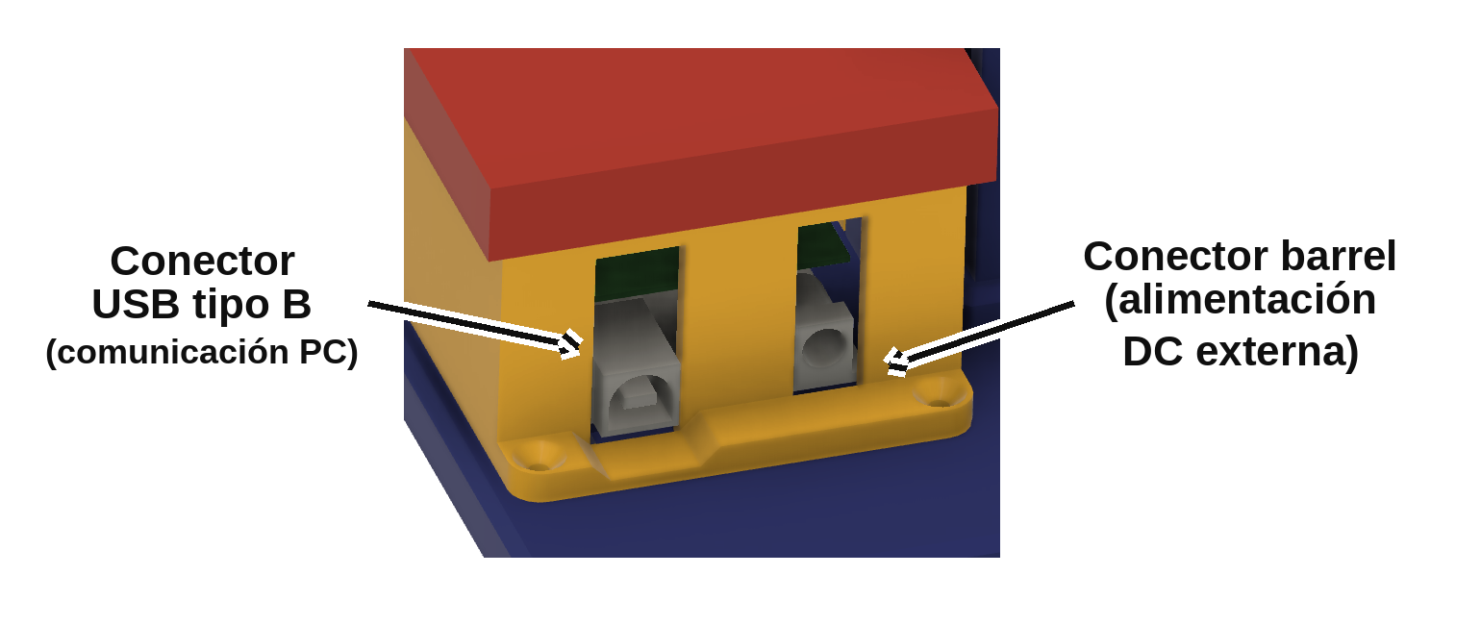
[picture p35: docs/manual/barrel_connector.png]
\\[-1pt]
{\footnotesize\textbf{USB: conexión al ordenador. Barrel jack: alimentación externa.}\\
Primero conecta USB; después, la fuente de alimentación.}
\vspace{-3pt}\end{center}

% Esquema de uso: representa los pasos, no una captura de la interfaz.
\begin{center}\vspace{-3pt}
\begin{tikzpicture}[
  paso/.style={draw=isa!65,fill=isa!5,rounded corners=4pt,
    minimum height=1.05cm,text width=3.1cm,align=center,
    font=\small,inner sep=5pt},
  flecha/.style={-{Stealth[length=5pt]},thick,draw=isa}
]
\node[paso] (bloque) {\textbf{1. Motor CC}\\Doble clic en el bloque};
\node[paso,right=0.55cm of bloque] (puerto) {\textbf{2. Arduino Port:}\\Elige tu puerto y pulsa OK};
\node[paso,right=0.55cm of puerto,fill=green!7,draw=green!40!black] (run)
  {\textbf{3. Run}\\Observa los Scopes};
\draw[flecha] (bloque) -- (puerto);
\draw[flecha] (puerto) -- (run);
\end{tikzpicture}
\vspace{-3pt}\end{center}

\begin{enumerate}
\item \textbf{Conecta el equipo.} Conecta el Arduino al ordenador mediante el cable USB. Si utilizas alimentación externa, conéctala después del USB: 8,4 V recomendados, máximo 9 V. Con USB solamente, el rango de velocidad es menor. Deja libre el eje del motor.
\item \textbf{Abre el modelo.} En MATLAB, entra en \texttt{software/matlab/} y abre el archivo \texttt{MotorCC\_V3\_Rxxxx.slx} correspondiente a tu versión. Ejemplo: \texttt{MotorCC\_V3\_R2024b.slx} para R2024b.
\item \textbf{Edita los parámetros de la máscara.} Con la simulación detenida, haz \textbf{doble clic en el bloque central Motor CC} (\texttt{Motor\_CC}). Se abrirá su ventana de parámetros o \emph{máscara}.
\item \textbf{Selecciona el puerto y acepta.} En el desplegable \textbf{Arduino Port:}, elige el puerto del Arduino y pulsa \textbf{OK}. Ejemplos: \texttt{COM3} (Windows), \texttt{/dev/cu.usbmodem...} (macOS) o \texttt{/dev/ttyACM0} (Linux). No hace falta abrir el editor de máscaras ni modificar los bloques interiores.
\item \textbf{Ejecuta la práctica.} Pulsa \textbf{Run} en Simulink. Abre los bloques \textbf{Scope} para observar las señales. La posición se expresa en grados y la velocidad en grados por segundo. El modelo suministrado aplica una señal de prueba en lazo abierto; no incluye un regulador conectado.
\item \textbf{Termina.} Pulsa \textbf{Stop} y espera a que el motor se detenga: tras 1 s sin recibir órdenes, Arduino reduce el PWM en 2 unidades cada 10 ms hasta cero. Para desconectar, retira primero la alimentación externa, si la hay, y después el USB.
\end{enumerate}

\textbf{¿No sabes cuál es el puerto?} Cierra la máscara, desconecta el USB y vuelve a abrirla para ver la lista. Ciérrala, conecta el USB y ábrela otra vez: el puerto nuevo es el del Arduino. Selecciónalo y pulsa \textbf{OK}.

\textbf{¿No conecta?} Cierra el Monitor Serie de Arduino y cualquier programa que use ese puerto. Comprueba el cable USB y vuelve a seleccionar el puerto en la máscara. Si faltan los bloques serie, comprueba que Instrument Control Toolbox está instalada.

\textbf{¿Arduino no tiene firmware?} Sigue el documento separado \emph{Instalación del firmware} (\texttt{instalacion\_firmware\_isa.pdf}).

\clearpage
{\LARGE\bfseries\color{isa} Anexo · Instalar Instrument Control Toolbox}\par
\medskip
La instalación se realiza desde MATLAB y solo hay que hacerla una vez en cada ordenador.

\begin{enumerate}
\item Conecta el ordenador a Internet y abre MATLAB.
\item En la pestaña \textbf{Home (Inicio)}, abre \textbf{Add-Ons (Complementos)} y selecciona \textbf{Get Add-Ons (Obtener complementos)}. El nombre puede variar según la versión.
\item Busca \textbf{Instrument Control Toolbox} y abre el producto de \textbf{MathWorks}. Selecciona la toolbox principal, no uno de sus paquetes de soporte para instrumentos concretos.
\item Pulsa \textbf{Install (Instalar)}. Si se solicita, inicia sesión con tu cuenta de MathWorks asociada a la licencia de la universidad y sigue las indicaciones del instalador.
\item Cuando termine, vuelve a MATLAB, escribe \textbf{\texttt{ver}} en la ventana de comandos y comprueba que aparece \textbf{Instrument Control Toolbox}. Después continúa con los pasos de la primera página.
\end{enumerate}

\textbf{Sobre la licencia.} Instrument Control Toolbox es un producto con licencia de MathWorks; no es una toolbox gratuita de distribución general. Si está incluida en tu licencia universitaria, puedes instalarla y utilizarla sin comprar una licencia adicional. Si el instalador no ofrece el producto, comprueba que has seleccionado la cuenta y la licencia correctas.

\textbf{Si no aparece la opción de instalar:} ejecuta el instalador de MATLAB de la misma versión que ya utilizas, selecciona la misma licencia y carpeta de instalación, y añade \textbf{Instrument Control Toolbox} a los productos instalados.

\smallskip
{\small Instrucciones oficiales: \href{https://www.mathworks.com/help/install/ug/add-to-existing-installation.html}{MathWorks · Añadir productos a una instalación de MATLAB}.}

\end{document}
