DocMuerde/Motor-CC-Control-Lab/docs/manual/user_manual_isa.tex

\documentclass[11pt,a4paper]{article}
\usepackage[utf8]{inputenc}
\usepackage[T1]{fontenc}
\usepackage[english]{babel}
\usepackage{lmodern}
\usepackage[left=2cm,right=2cm,top=1.8cm,bottom=1.8cm]{geometry}
\usepackage{graphicx}
\usepackage{xcolor}
\usepackage{tikz}
\usetikzlibrary{arrows.meta,positioning}
\usepackage{enumitem}
\usepackage[hidelinks]{hyperref}
\definecolor{isa}{RGB}{0,70,130}
\setlength{\parindent}{0pt}
\setlength{\parskip}{3pt}
\setlist[enumerate]{leftmargin=*,itemsep=3pt,topsep=3pt}
\setlist[itemize]{leftmargin=*,itemsep=2pt,topsep=3pt}
\begin{document}
\sloppy
\noindent\begin{minipage}[c]{0.76\linewidth}
{\LARGE\bfseries\color{isa} Quick start guide}\par
{\large DC motor control lab}\par
{\small ISA · University of Seville\\\href{mailto:ialvarado@us.es}{ialvarado@us.es}}
\end{minipage}\hfill
\begin{minipage}[c]{0.22\linewidth}
\centering

\end{minipage}\par
\smallskip\hrule\medskip

\textbf{Starting point:} the rig is assembled and the firmware is already installed on Arduino.

\textbf{Required software: MATLAB with Simulink. Instrument Control Toolbox is the only additional toolbox required to use the rig.} Arduino IDE, the Arduino support package and other toolboxes are not needed to communicate with the rig.

\textbf{Check the installation:} in the MATLAB \emph{Command Window}, type \textbf{\texttt{ver}} and press Enter. \textbf{Instrument Control Toolbox} must appear in the list of installed products. If it is missing, follow the installation appendix at the end of this guide.

\begin{center}\vspace{-3pt}
\resizebox{!}{2.3cm}{%
\begin{tikzpicture}
\node[inner sep=0] at (0,0) {};
\fill[white] (-5.5,-2.3) rectangle (-2.6,2.3);
\fill[white] (2.1,-2.3) rectangle (5.5,2.3);
\node[align=center,font=\bfseries\small,text width=2.6cm] at (-4.1,0) {USB type B\\PC connection};
\node[align=center,font=\bfseries\small,text width=3cm] at (3.8,0) {Barrel jack\\External DC power};
\end{tikzpicture}}\\[-1pt]
{\footnotesize\textbf{USB: connection to the computer. Barrel jack: external power.}\\
Connect USB first, then the external power supply.}
\vspace{-3pt}\end{center}

\begin{center}\vspace{-3pt}
\begin{tikzpicture}[
  paso/.style={draw=isa!65,fill=isa!5,rounded corners=4pt,
    minimum height=1.05cm,text width=3.1cm,align=center,
    font=\small,inner sep=5pt},
  flecha/.style={-{Stealth[length=5pt]},thick,draw=isa}
]
\node[paso] (bloque) {\textbf{1. Motor CC}\\Double-click the block};
\node[paso,right=0.55cm of bloque] (puerto) {\textbf{2. Arduino Port:}\\Choose your port, then OK};
\node[paso,right=0.55cm of puerto,fill=green!7,draw=green!40!black] (run)
  {\textbf{3. Run}\\View the Scopes};
\draw[flecha] (bloque) -- (puerto);
\draw[flecha] (puerto) -- (run);
\end{tikzpicture}
\vspace{-3pt}\end{center}

\begin{enumerate}
\item \textbf{Connect the rig.} Connect Arduino to the computer using USB. If using an external supply, connect it after USB: 8.4 V recommended, 9 V maximum. USB power alone gives a smaller speed range. Keep the motor shaft clear.
\item \textbf{Open the model.} In MATLAB, browse to \texttt{software/matlab/} and open the \texttt{MotorCC\_V3\_Rxxxx.slx} file for your release. Example: \texttt{MotorCC\_V3\_R2024b.slx} for R2024b.
\item \textbf{Edit the mask parameters.} With the simulation stopped, \textbf{double-click the central Motor CC block} (\texttt{Motor\_CC}). Its parameter dialog, or \emph{mask}, opens.
\item \textbf{Select the port and confirm.} In the \textbf{Arduino Port:} dropdown, choose the Arduino port and click \textbf{OK}. Examples: \texttt{COM3} (Windows), \texttt{/dev/cu.usbmodem...} (macOS), or \texttt{/dev/ttyACM0} (Linux). There is no need to open the mask editor or change internal blocks.
\item \textbf{Run the experiment.} Click \textbf{Run} in Simulink. Open the \textbf{Scope} blocks to view the signals. Position is in degrees and velocity in degrees per second. The supplied model applies an open-loop test signal; no feedback controller is connected.
\item \textbf{Finish.} Click \textbf{Stop} and wait for the motor to stop: after 1 s without commands, Arduino reduces PWM by 2 units every 10 ms until zero. Disconnect external power first, if connected, then USB.
\end{enumerate}

\textbf{Which port belongs to Arduino?} Close the mask, unplug USB and reopen the mask to inspect the list. Close it, reconnect USB and open it again: the new port belongs to Arduino. Select it and click \textbf{OK}.

\textbf{Connection problem?} Close Arduino Serial Monitor and any other program using the port. Check the USB cable and select the port again in the mask. If serial blocks are missing, check that Instrument Control Toolbox is installed.

\textbf{No firmware on Arduino?} Follow the separate \emph{Firmware installation} guide (\texttt{firmware\_installation\_isa.pdf}).

\clearpage
{\LARGE\bfseries\color{isa} Appendix · Install Instrument Control Toolbox}\par
\medskip
Installation is performed from MATLAB and is needed only once on each computer.
\begin{enumerate}
\item Connect the computer to the Internet and open MATLAB.
\item On the \textbf{Home} tab, open \textbf{Add-Ons} and choose \textbf{Get Add-Ons}. The wording may vary by release.
\item Search for \textbf{Instrument Control Toolbox} and open the product published by \textbf{MathWorks}. Select the main toolbox, rather than a support package for specific instruments.
\item Click \textbf{Install}. If prompted, sign in with your MathWorks account associated with the university license and follow the installer instructions.
\item When installation finishes, return to MATLAB, type \textbf{\texttt{ver}} in the Command Window and check that \textbf{Instrument Control Toolbox} appears. Then continue with the steps on the first page.
\end{enumerate}

\textbf{About the license.} Instrument Control Toolbox is a licensed MathWorks product; it is not generally available as a free toolbox. If it is included in your university license, you can install and use it without purchasing an additional license. If the installer does not offer the product, check that you have selected the correct account and license.

\textbf{If installation is not offered:} run the MATLAB installer for your installed release, select the same license and installation folder, and add \textbf{Instrument Control Toolbox} to the installed products.

\smallskip
{\small Official instructions: \href{https://www.mathworks.com/help/install/ug/add-to-existing-installation.html}{MathWorks · Add products to an existing MATLAB installation}.}
\end{document}
