DocMuerde/Motor-CC-Control-Lab/docs/manual/firmware_installation_isa.pdf

## Firmware installation

### Arduino UNO · DC motor control lab

ISA · University of Seville
ialvarado@us.es

When to use this guide. Only to prepare a new Arduino, replace the board or update the firmware. If the rig already works, go straight to user_manual_isa.pdf. Uploaded firmware remains stored when Arduino is unplugged.

### 1. Prepare the computer

You need Arduino IDE 2.x, an Arduino UNO, a USB data cable and a copy of the repository. MATLAB is not involved in uploading the firmware.

Download the files first. Open github.com/DocMuerde/Motor-CC-Control-Lab, click Code > Download ZIP and extract the ZIP into a folder on your computer.

Alternative using Git. If you have Git, open a terminal in the folder where you want to save the project and run:

git clone https://github.com/DocMuerde/Motor-CC-Control-Lab.git

In either case, locate the extracted or cloned folder: it contains firmware/arduino/main/main.ino. Do not open the file from inside the ZIP.

Install the Arduino libraries

1. Open Arduino IDE and its Library Manager.
2. Find and install AS5047P by Marginally Clever. This is the library used by #include <AS5047P.h>.
3. Find and install MsTimer2. This is the library used by #include <MsTimer2.h>. Built-in Arduino core libraries come with the board environment.

These libraries are needed on the computer that compiles and uploads the firmware; they are not needed on every computer running the rig from MATLAB.

1

Firmware installation · Arduino UNO

### 2. Upload the program

1. Leave external power disconnected and connect Arduino to the computer by USB. Keep the motor shaft clear. Close simulations and any program using the serial port.
2. In Arduino IDE, select File > Open and, inside the downloaded or cloned folder, open firmware/arduino/main/main.ino. Keep the folder name main and the file name main.ino.
3. Under Tools > Board, select Arduino Uno from Arduino AVR Boards; install that package through Boards Manager if it is missing.
4. Under Tools > Port, select the Arduino port. If unsure, unplug and reconnect USB to identify the port that appears.
5. Click Verify to compile. If a missing-library error appears, check the two libraries listed above.
6. Click Upload and wait for confirmation that the upload completed without errors.

### 3. Check and switch to MATLAB

For a basic check, you can open Serial Monitor at 115200 baud. The firmware sends binary packets every 10 ms, so unreadable symbols are expected. If encoder initialization fails, the firmware prints an SPI connection error every 5 s. Serial activity alone does not verify the motor drive. Do not send text commands.

Close Serial Monitor to release the port. Follow the quick start guide: open the model for your MATLAB release, double-click Motor CC, select the port, click OK, then Run. Check position and velocity readings in the Scopes.

Upload fails? Check board and port selection, close Serial Monitor and MATLAB, and try another USB data cable. If measurements are missing, check the shield and encoder connections with the rig disconnected.

Separate dependencies: using the rig requires MATLAB with Simulink and Instrument Control Toolbox as the only additional toolbox. The Arduino libraries above are used only to install or update the firmware.

2
