DocMuerde/Motor-CC-Control-Lab/hardware/pcb/Schematic_Control_Motor_CC_2026-11-06.pdf

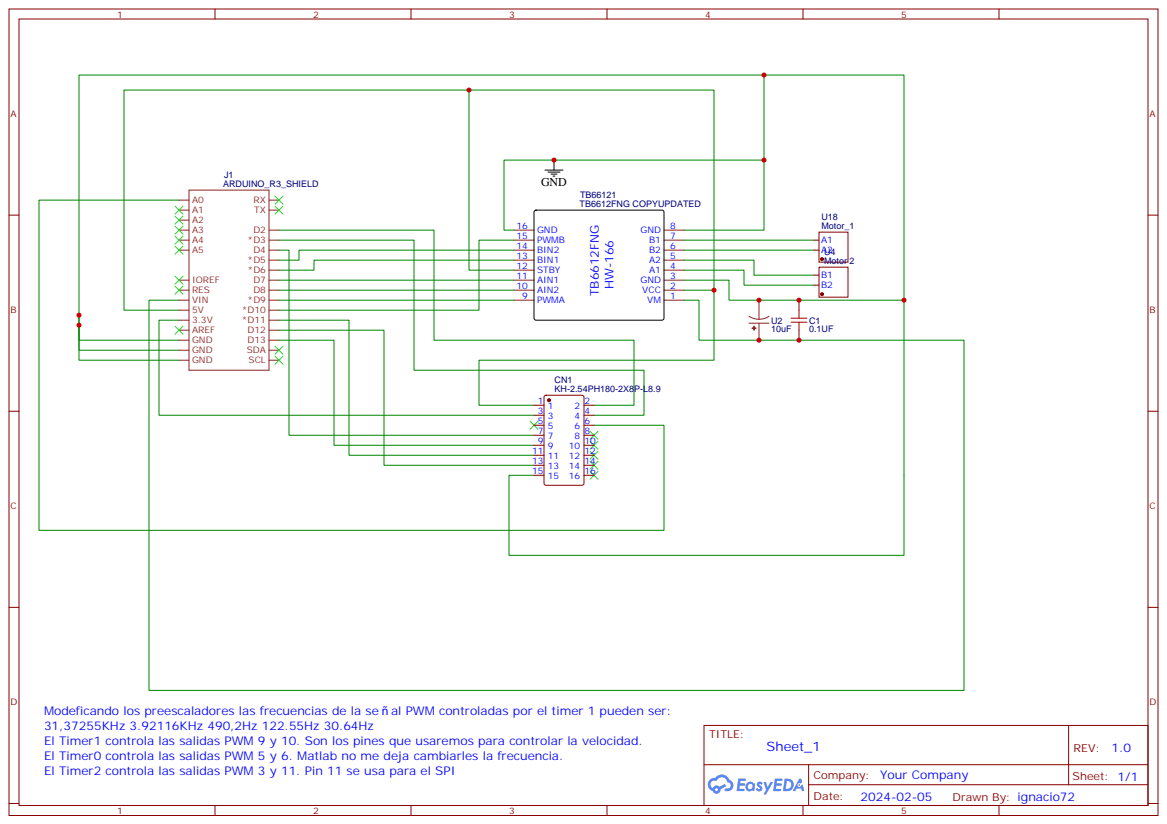
[picture p38: page 1]

Modeficando los preescaladores las frecuencias de la se al PWM controladas por el timer 1 pueden ser:
31,37255KHz 3.92116KHz 490,2Hz 122.55Hz 30.64Hz
El Timer1 controla las salidas PWM 9 y 10. Son los pines que usaremos para controlar la velocidad.
El Timer0 controla las salidas PWM 5 y 6. Matlab no me deja cambiarles la frecuencia.
El Timer2 controla las salidas PWM 3 y 11. Pin 11 se usa para el SPI
