DocMuerde/Motor-CC-Control-Lab/datasheets/driver/SparkFun_Motor_Driver-TB6612FNG_v11c/SparkFun_Motor_Driver-TB6612FNG_v11c.brd

## EAGLE design datasheets/driver/SparkFun_Motor_Driver-TB6612FNG_v11c/SparkFun_Motor_Driver-TB6612FNG_v11c.brd (2026-11-06)

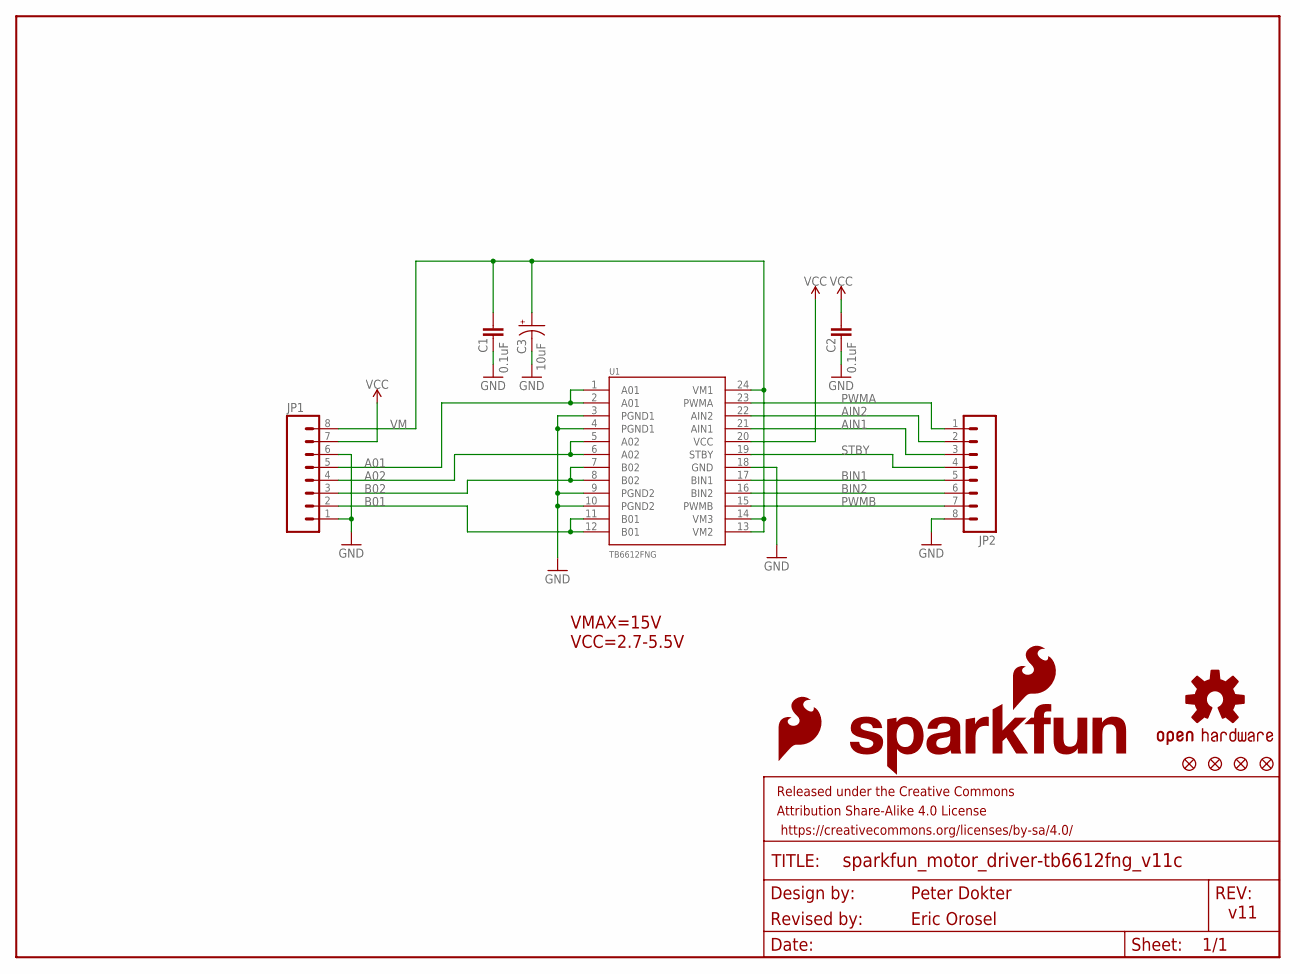
[picture p39: schematic SparkFun_Motor_Driver-TB6612FNG_v11c.sch]

Parts:
C1, C2: 0.1uF; 0402
C3: 10uF; EIA3528
FD1, FD2, FD3, FD4: FIDUCIALUFIDUCIAL; FIDUCIAL-MICRO
FRAME1: FRAME-LETTER; CREATIVE_COMMONS
JP1, JP2: M0875_PERCENT_REDUCED; 1X08_OFFSET_REDUCED
LOGO1: SFE_LOGO_FLAME.1_INCH; SFE_LOGO_FLAME_.1
LOGO2: OSHW-LOGOS; OSHW-LOGO-S
LOGO4: SFE_LOGO_NAME_FLAME.1_INCH; SFE_LOGO_NAME_FLAME_.1
U1: TB6612FNG; SSOP24

Connections:
A01: JP1.5, U1.1 (A01), U1.2 (A01)
A02: JP1.4, U1.5 (A02), U1.6 (A02)
AIN1: JP2.3, U1.21 (AIN1)
AIN2: JP2.2, U1.22 (AIN2)
B01: JP1.2, U1.11 (B01), U1.12 (B01)
B02: JP1.3, U1.7 (B02), U1.8 (B02)
BIN1: JP2.5, U1.17 (BIN1)
BIN2: JP2.6, U1.16 (BIN2)
GND: C1.2, C2.2, C3.C (-), JP1.1, JP1.6, JP2.8, U1.3 (PGND1), U1.4 (PGND1), U1.9 (PGND2), U1.10 (PGND2), U1.18 (GND)
PWMA: JP2.1, U1.23 (PWMA)
PWMB: JP2.7, U1.15 (PWMB)
STBY: JP2.4, U1.19 (STBY)
VCC: C2.1, JP1.7, U1.20 (VCC)
VM: C1.1, C3.A (+), JP1.8, U1.13 (VM2), U1.14 (VM3), U1.24 (VM1)

Notes on the sheet:
v11
Peter Dokter
Revised by:
Eric Orosel
VMAX=15V VCC=2.7-5.5V

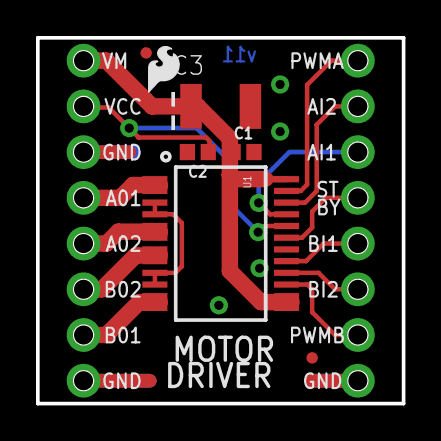
[picture p40: board SparkFun_Motor_Driver-TB6612FNG_v11c.brd from above]

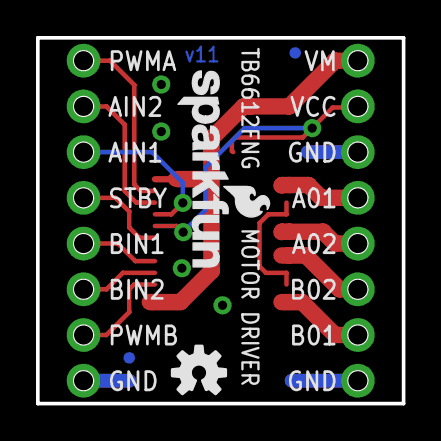
[picture p41: board SparkFun_Motor_Driver-TB6612FNG_v11c.brd from below]

Board: 2 copper layers, 20.3 x 20.3 mm, 14 parts (4 on the bottom side), 14 nets.
