DocMuerde/Motor-CC-Control-Lab/(commit log)

2026-11-05 feat(firmware): añadir código Arduino comentado y actualizar README
    - main.ino: código original comentado en profundidad (protocolo binario,
    observador de Luenberger documentado y desactivado intencionalmente,
    gestión de vueltas, PWM a 31250 Hz)
    - README firmware: protocolo corregido a binario, pines corregidos (CS=D4),
    librerías necesarias documentadas (AS5047P, MsTimer2)
2026-11-05 fix: corregir driver (TB6612FNG) y toolbox MATLAB
    - Driver actualizado de L298N a TB6612FNG en todos los archivos
    - Instrument Control Toolbox confirmada como única dependencia MATLAB
    - Afecta: README.md, firmware/README.md, hardware/pcb/README.md,
    software/matlab/README.md, firmware/arduino/main/main.ino
    [main.ino]
2026-11-06 docs(datasheets): add encoder and driver documentation and files
    Encoder (AS5047P):
    - AS5047P-Datasheet.pdf: official datasheet
    - AS5047P.png: component photo from the rig
    - README.md: pinout, key parameters, Arduino wiring, library info
    Driver (SparkFun TB6612FNG ROB-14451):
    - TB6612FNG-Datasheet-Toshiba.pdf: Toshiba chip datasheet
    - SparkFun_Motor_Driver-TB6612FNG_v11c.pdf: PCB schematic
    - SparkFun_Motor_Driver-TB6612FNG_v11c/ Eagle design files (.brd + .sch)
    - README.md: specs, pinout, wiring to Arduino UNO
    Claude-Session: https://claude.ai/code/session_01KSpm3JxmRrusHoe4NPLe78
    [SparkFun_Motor_Driver-TB6612FNG_v11c.brd, SparkFun_Motor_Driver-TB6612FNG_v11c.sch]
2026-11-06 docs(datasheets): add maxon motor and gearbox documentation
    Motor A-max 22, 5W (Art. 110120):
    - Amax22-110120-Datasheet.pdf: catalog page with electrical/mechanical parameters
    - Amax22-110120-CAD.zip: 3D STEP model
    - README.md: key specs, product page link
    Reductora GP 22 B (Art. 110356):
    - GP22B-110356-Datasheet.pdf: catalog page with reduction ratio and torque specs
    - GP22B-110356-CAD.zip: 3D STEP model (covers variants 110355–110359)
    - README.md: key specs, product page link
    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
2026-11-06 feat: add rig render to README cover
    Add Fusion 360 render of the complete lab rig to the repository
    cover page (docs/images/equipo_render.png). Image shows the full
    assembly: base, electronics enclosure, inertia disk, motor and
    gearbox.
    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
2026-11-06 docs: improve README description and add 3D/STEP hardware files
    [Adaptador.stl, Base.stl, Caja.stl, Disco_inercia.stl, Eq_practicas v83 v7.step, SMotor.stl, SSensor_integrado.stl, Soporte_disco.stl]
2026-11-06 docs: fix driver in schematic (TB6612FNG) and improve system description
2026-11-06 feat(hardware): add PCB shield — schematic, gerbers, BOM, 3D model and render
    [BOM_Control_Motor_CC_2026-11-06.csv]
2026-11-06 refactor: renombrar GEPOC → ISA en todo el repositorio y guías de prácticas
    [Adaptador.stl, BOM_Control_Motor_CC_2026-11-06.csv, Base.stl, Caja.stl, Disco_inercia.stl, Eq_practicas v83 v7.step, SMotor.stl, SSensor_integrado.stl]
2026-11-06 docs: añadir sección de estado del proyecto y próximos pasos al README
2026-11-06 docs: añadir manual de usuario para profesores
2026-11-07 docs: add English manual, update Spanish manual, rename Simulink model to V3
    - Apply 7 pending corrections to manual_usuario_isa.tex:
    * §1.2 infobox: correct AS5047P encoder range, explain angle accumulation
    and unbounded output (-∞, +∞); add Luenberger observer note
    * §2.2 firmware check: clarify binary data looks like garbled characters
    * §3.1: rename MotorCC_V2.slx → MotorCC_V3.slx (3 occurrences)
    * §3.3: add warnbox — stop simulation with motor at rest
    * §4.1: restructure serial-protocol table with meaning on second row
    * §4.2: rename section 'tensión media', clarify PWM average voltage formula
    * §4.3 config.m: remove obsolete section
    - Regenerate manual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
2026-11-07 docs: describe Simulink model internals, fix README references
    README.md:
    - software/matlab/ description: "Scripts MATLAB" → "Modelo Simulink MotorCC_V3.slx"
    - Getting Started step 5: describe how to open the model and select the port
    - Fix broken link to non-existent docs/bill_of_materials.md
    - MotorCC_V2.slx → MotorCC_V3.slx in "Estado del proyecto"
    software/matlab/README.md (new content):
    - Full bilingual description of MotorCC_V3.slx structure
    - Root-level diagram: Pulse Generator + Sum + Motor_CC block
    - Motor_CC masked subsystem: 3 Instrument Control Toolbox blocks
    · Serial Configuration (115200 baud, 8N1, little-endian, priority −200000)
    · Serial Send: 'A' | int16(u) | '\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
2026-11-07 docs(matlab): add screenshots and wire images into bilingual README
    Add 6 annotated screenshots to docs/images/matlab/:
    01_root_level.png — Simulink root level (Pulse Generator, Motor_CC, Scopes)
    02_motor_cc_mask_dialog.png — Motor_CC mask dialog with port dropdown
    03_motor_cc_interior.png — Subsystem interior (ICT blocks visible)
    04_serial_configuration.png — Serial Configuration dialog (115200, 8N1, LE)
    05_serial_send.png — Serial Send dialog (header 'A', LF terminator)
    06_serial_receive.png — Serial Receive dialog (header 'V', 3×float, 100 Hz)
    Replace all six <!-- IMAGEN/IMAGE: ... --> placeholder comments in
    software/matlab/README.md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
2026-11-07 docs(matlab): add mask reproduction guide with screenshots
    Add 4 annotated screenshots of the Mask Editor and Block Properties:
    07_mask_editor_parameters_group.png — Parameters & Dialog tab overview
    08_mask_editor_portname_props.png — PortName parameter properties (popup, Tunable on)
    09_mask_editor_code_tab.png — Code tab (empty; shows where NOT to put OpenFcn)
    10_block_properties_openfcn.png — Block Properties → Callbacks → OpenFcn with code
    Add bilingual section "Cómo está construida la máscara / How the mask is built"
    to software/matlab/README.md covering:
    - Step-by-step guide to recreate the mask from scratch
    - Why the OpenFcn lives in Block Prop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
2026-11-07 docs(matlab): add bilingual signal-flow diagrams for Motor_CC interior
    Generate two annotated flowcharts (ES/EN) with Python/matplotlib:
    diagram_motor_cc_es.png — Spanish version
    diagram_motor_cc_en.png — English version
    Each diagram shows the full signal path vertically:
    u → Saturation → ZOH → int16 → Serial Send → Arduino
    Arduino → Serial Receive → single→double → Demux → θ, ω, Display
    Serial Configuration (priority −200 000) → initialises Send & Receive
    Replace the ASCII art in the Motor_CC interior section of
    software/matlab/README.md with the corresponding image in each language.
    Claude-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
2026-11-07 diagrama interior Motor_CC: flechas SC en L sin cruzar Arduino, PWM en Display interno
2026-11-07 README matlab: todo español primero, luego inglés; OpenFcn integrado en guía de máscara
2026-11-07 README: separador visual ES/EN; nota sobre Type Options en guía de máscara
2026-11-07 docs: add complete English sections to all READMEs
    - datasheets/README.md: added full EN section (was Spanish-only)
    - datasheets/driver/README.md: expanded EN stub → full files table,
    specs table, Arduino connections table, STBY note, references
    - datasheets/encoder/README.md: expanded EN stub → full files table,
    params table, Arduino connections table, library section, reference
    - datasheets/motor/README.md: expanded EN stub → files table, specs
    table, full references
    - datasheets/reductora/README.md: expanded EN stub → files table, specs
    table, sold-with-motor note, full references
    - firmware/arduino/README.md: expanded EN stub → full libraries table,
    complete protocol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
2026-11-07 lab01: rewrite section 3 as practical startup guide
    - Rename section from 'El modelo de Simulink MotorCC_V2' to
    'Puesta en marcha del equipo'
    - Expand startup steps into a 6-step numbered guide:
    1. Connect Arduino via USB
    2. Open software/matlab/ folder in MATLAB
    3. Open MotorCC_V3.slx (double-click or open())
    4. Double-click Motor_CC block → select serial port → OK
    5. Click Run (real-time 100 Hz)
    6. Verify scope shows live θ and ω; troubleshooting hints
    - Add notabox: port is remembered until next session change
    - Update all MotorCC_V2 → MotorCC_V3 references throughout
    Claude-Session: https://claude.ai/code/se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
2026-11-07 lab01: add system introduction section, fix tikz babel error
    - New \section{Introducción} with equipment overview, motor model
    (G(s)=K/(τs+1)) and 3-lab sequence description
    - Fix \\[-3pt] inside tikz node label (babel conflict) → \shortstack{}
    Claude-Session: https://claude.ai/code/session_01KSpm3Md1NMcYM7fBNKqnrc
2026-11-07 lab01: add Beamer presentation (identificación del motor CC)
    - New slides format based on Presentacion_arduino_V2.tex style (Shadow theme)
    - Adapted from PowerPoint Ca2_GITI_2627_P2_v3 (two-tank → motor CC)
    - Sections: intro al sistema, lab virtual Simulink, puesta en marcha,
    experimentos, resumen
    - 23 frames: Dashboard controls, Scope config, saturación, característica
    estática, ensayo escalón (identificación K/τ), barrido frecuencial
    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
2026-11-07 lab01 slides: fix pdflatex UTF-8 encoding errors
    Replace em/en dashes (—, –) with LaTeX --- and -- equivalents.
    pdflatex+inputenc[utf8] does not support U+2014/U+2013 directly.
    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
2026-11-07 lab01 slides: fix Beamer headline -- remove incompatible section redefs
    The \renewcommand{\section} / \renewcommand{\subsection} with \label
    and \nameref navigation conflicted with Beamer's internal section handling,
    causing 'File ended while scanning \@writefile' at \begin{document}.
    Replaced with a simple headline using \insertsectionhead / \insertsubsectionhead
    which is fully compatible with Beamer.
    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
2026-11-07 lab01 slides: add [fragile] to frames containing lstlisting
    In Beamer, frames with verbatim content (lstlisting, verbatim, etc.)
    MUST be declared \begin{frame}[fragile]{...}, otherwise Beamer's
    internal frame processing breaks the verbatim scanner and lstlisting
    never finds its \end{lstlisting} tag.
    Fixed 3 frames: Ejercicio 1, Experimento 2, Experimento 3.
    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
2026-11-07 lab01 slides: fix voltage formula + create figuras/ folder
    - Replace hardcoded 12V with V_alim throughout:
    * Veq frame: explain 3 modes (battery 8.4V, max 9V, USB 5V)
    * K identification formula
    * init_motor.m script (V_alim = 8.4)
    * Validation script
    * Results table: add V_alim row
    - Create labs/lab01/figuras/ with README listing pending screenshots
    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
2026-11-07 software: add script to export Simulink model to older versions
    exportar_versiones.m exports MotorCC_V3.slx to R2020b–R2024b
    using save_system + ExportToVersion. Run from MATLAB R2025a.
    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
2026-11-07 software: rename model to R2025b, add R2024b export, update script
    - Rename MotorCC_V3.slx → MotorCC_V3_R2025b.slx (master version)
    - Add MotorCC_V3_R2024b.slx (exported from MATLAB)
    - Update exportar_versiones.m to reference new master filename
    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
2026-11-07 software: add Simulink model exports for R2020b–R2024b
2026-11-07 docs: replace ASCII system diagram with matplotlib PNG
    Add docs/images/diagram_sistema_es.png (coloured block diagram
    showing PC/MATLAB → Arduino+Shield → TB6612FNG driver → Maxon motor
    ← AS5047P encoder loop) and update README.md to embed it via <img>.
    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
2026-11-08 docs: improve system diagram — larger fonts, coloured labels
    Increase all font sizes (~2×), move PC↔Arduino arrow labels outside
    the box area, and use coloured badge backgrounds on all signal labels
    so they read clearly at GitHub's display width.
    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
2026-11-08 docs: add Montaje and Futuras mejoras sections (ES + EN)
    Add assembly step-by-step instructions and two future-improvement notes:
    metal heat-set inserts for the screw holes, and cable management clips
    on the underside of the base for the motor-to-driver wiring.
    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
2026-11-08 docs: fix diagram return arrow (θ, θ̇); add BOM to assembly section
    - System diagram: return channel now correctly shows θ and θ̇
    (position and angular velocity) flowing Arduino → PC/MATLAB
    - README: add bill-of-materials table (ES + EN) under Montaje/Assembly
    listing motor, encoder, shield, Arduino, rubber feet, M3/M2 screws,
    JST cable and optional battery
    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
2026-11-08 docs: specify screw quantities and lengths in BOM
    12× M3×12 for bench/motor bracket, 4× M2×10 for encoder and cap.
    Note that the same screws will be reused once heat-set inserts are fitted.
    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
2026-11-08 docs: update project status section
    Completed: mark Simulink export done (MotorCC_V3_R2025b + versions),
    add lab01 slides and README diagram/assembly docs.
    Pending: reorder list — drop export task, add 3D redesign for
    heat-set inserts and cable management clips as new items.
    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
2026-11-08 docs: replace 'batería' with '8.4 V power supply' throughout
    The rig is powered by a 2S LiPo charger (8.4 V, barrel jack), not a
    battery. Update README BOM, assembly steps and lab01 slides accordingly.
    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
2026-11-09 feat(firmware): watchdog serie 1s + fix nombres exportar versiones Simulink
    [main.ino]
2026-11-09 fix: puerto serie propagado desde máscara + watchdog Arduino + fix nombres exportar versiones
2026-11-09 feat(firmware): parada suave en watchdog de comunicación (~1,3 s)
    Sustituye el corte brusco de PWM (pwm=0 instantáneo) por una rampa
    de bajada gradual: cada período de muestreo (Ts=10 ms) se reduce |pwm|
    en WATCHDOG_RAMP_STEP=2, tardando ~1,3 s en parar desde plena potencia.
    Esto protege los engranajes de la reductora frente al golpe mecánico
    que se producía al perder la comunicación con MATLAB con el motor en
    marcha (p. ej. al detener la simulación sin poner pwm=0 antes).
    Cuando la comunicación se restablece, la operación normal se reanuda
    de inmediato en el mismo ciclo de muestreo.
    Claude-Session: https://claude.ai/code/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
2026-11-09 Actualiza la selección de puerto de MotorCC V3
2026-11-09 Añade los modelos Simulink MotorCC V2
